lucedoriente/Aleste520ex/pcb_top.png

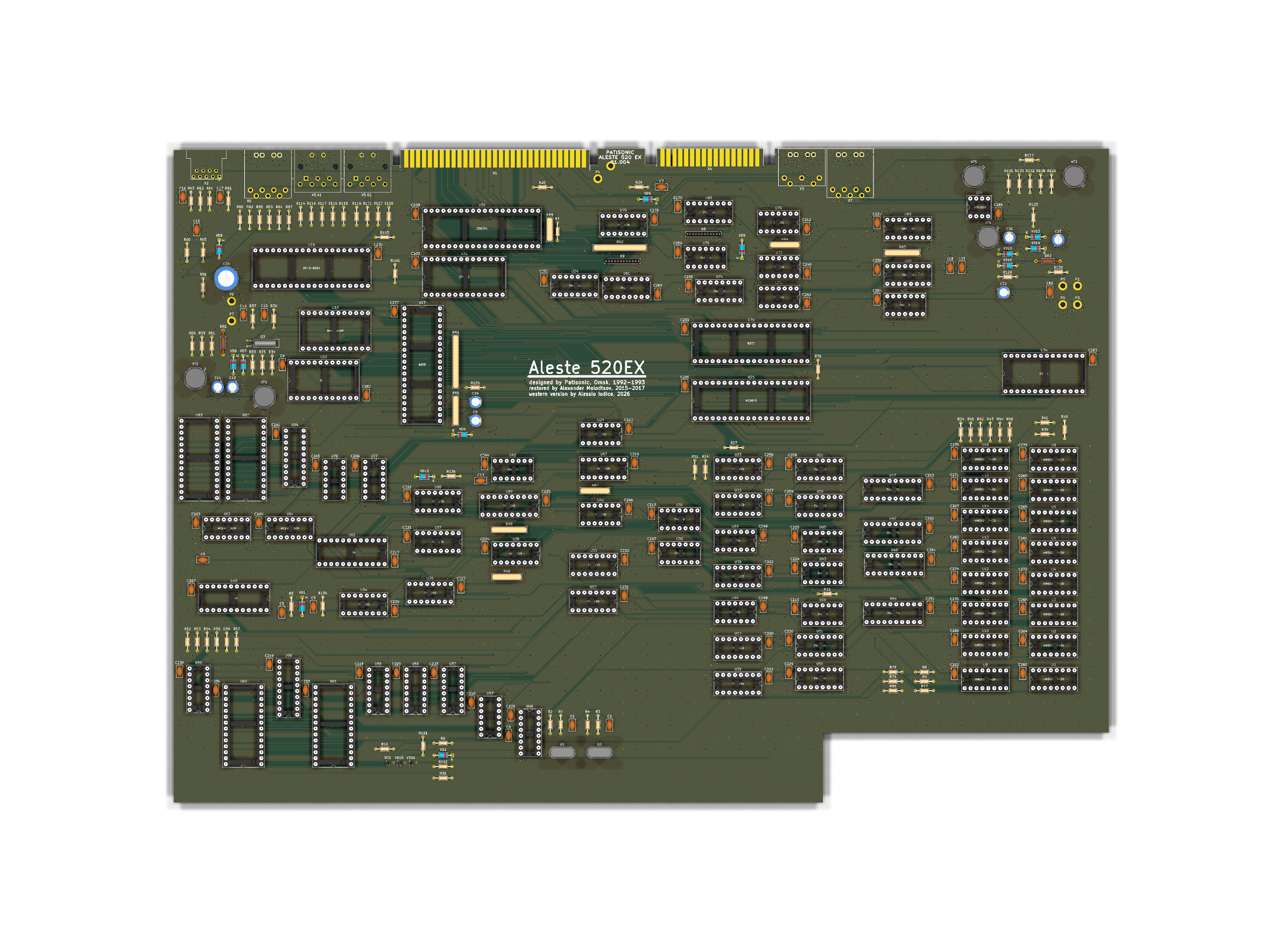
pcb_top.png
