lucedoriente/Aleste520ex/Schema/Aleste-Schematic1.gif

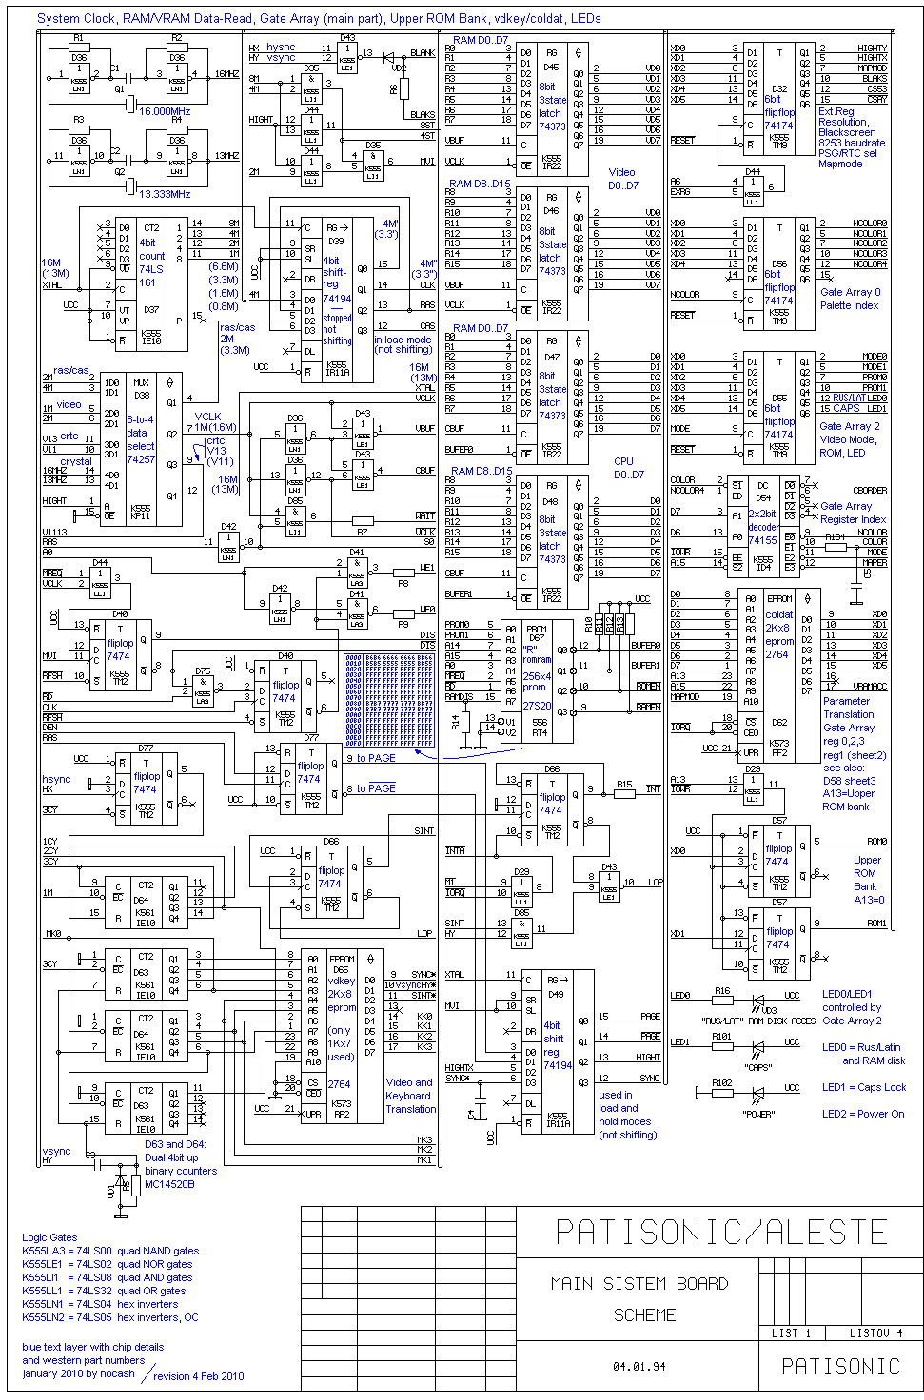
Schema/Aleste-Schematic1.gif
