lucedoriente/Aleste520ex/Schema/Aleste-Schematic2.gif

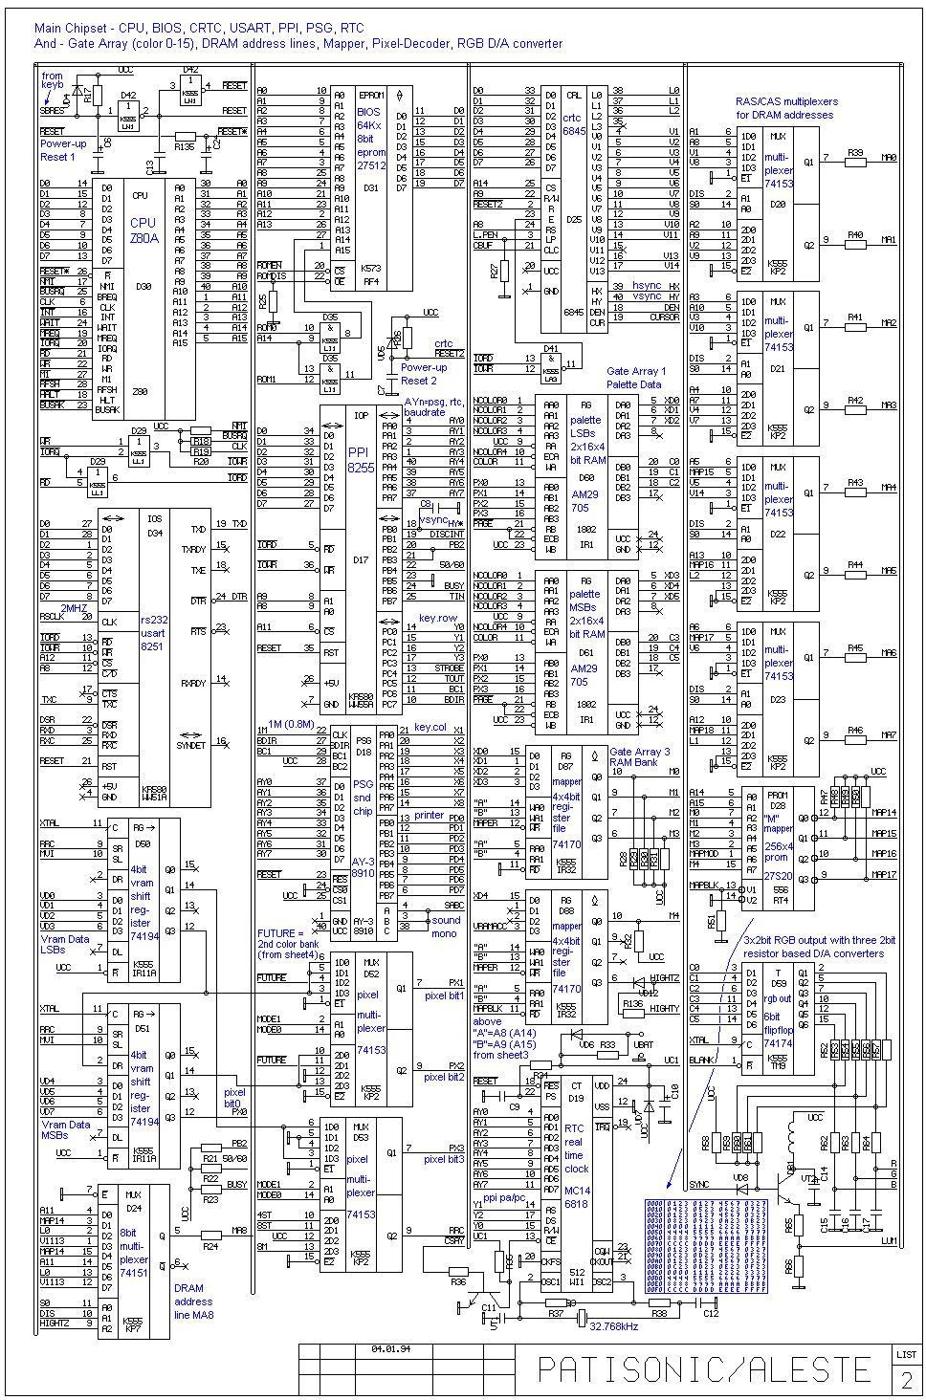
Schema/Aleste-Schematic2.gif
