lucedoriente/Aleste520ex/Schema/Aleste-Schematic3.gif

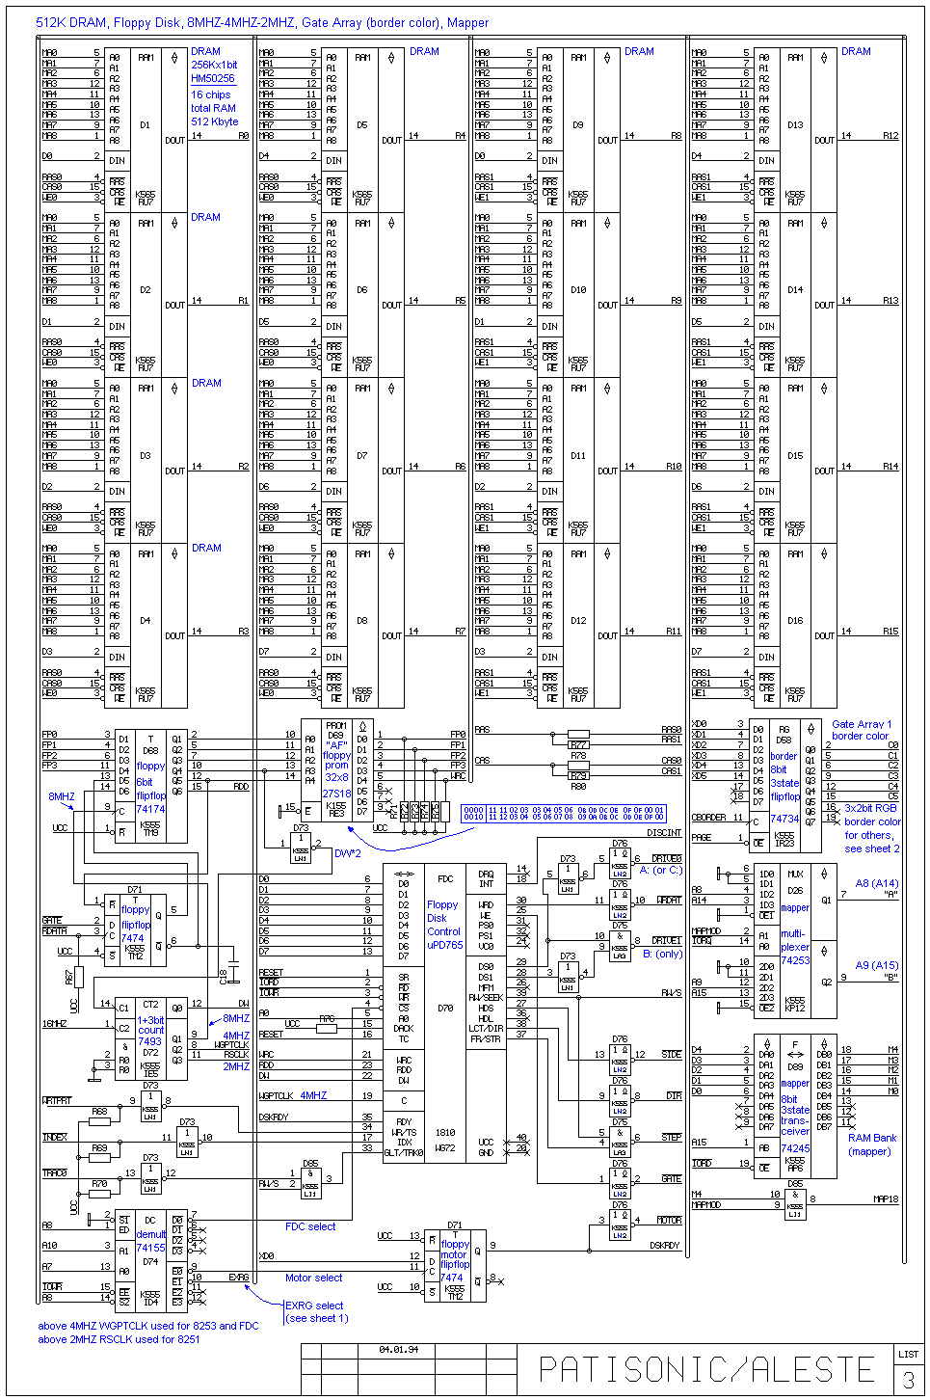
Schema/Aleste-Schematic3.gif
