lucedoriente/Aleste520ex/Schema/Aleste-Schematic4.gif

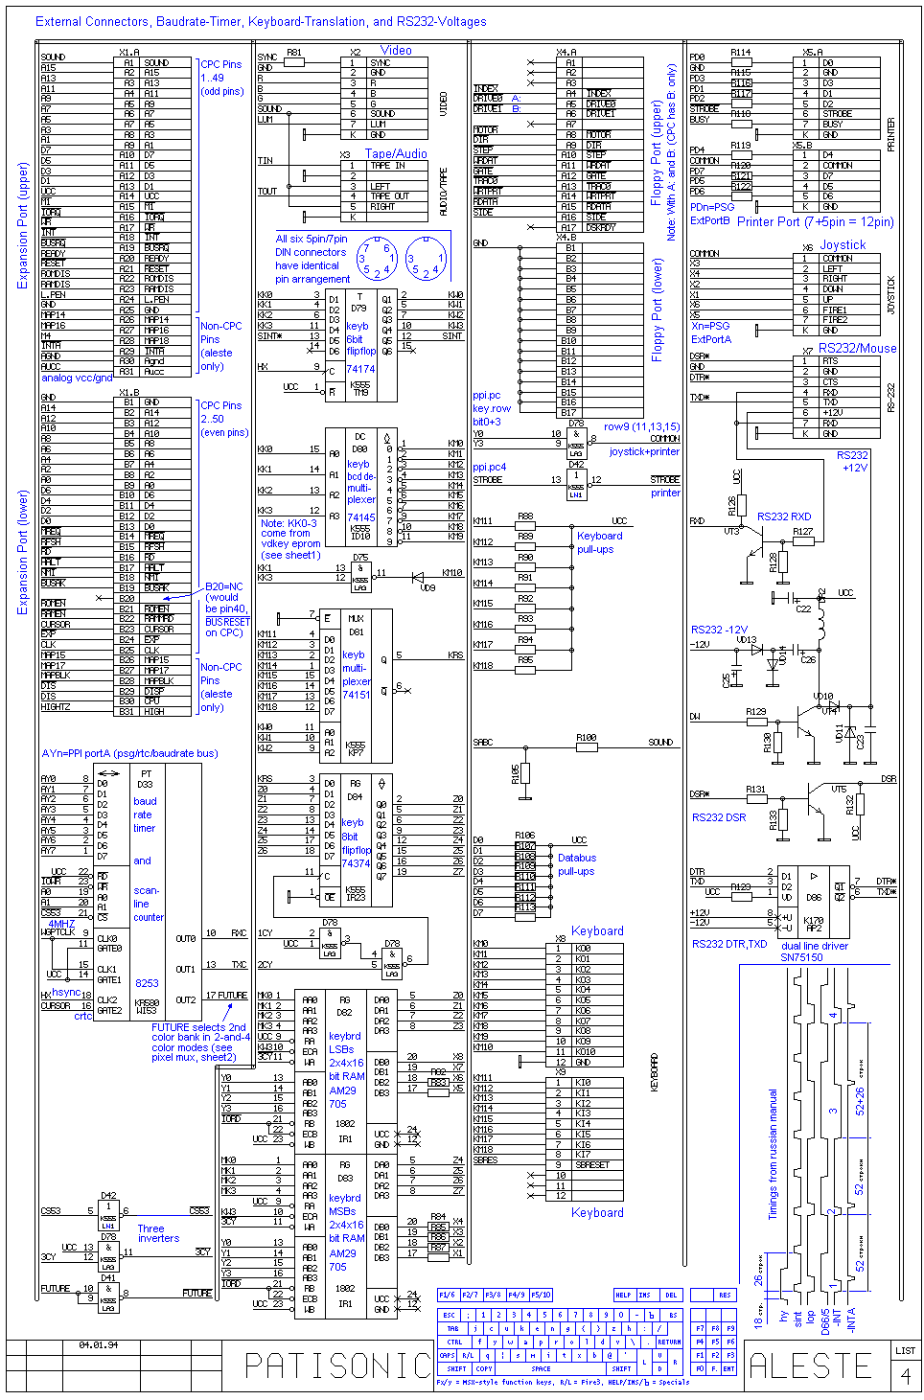
Schema/Aleste-Schematic4.gif
