lucedoriente/Aleste520ex/Componenti_Aleste520v4.csv

Tipo Componente | Numero (Designatore) | Codice / Valore Componente | Footprint THT
Circuito Integrato (IC) | U1 | HM50256P-20 | DIP-16_W7.62mm_Socket
Circuito Integrato (IC) | U2 | HM50256P-20 | DIP-16_W7.62mm_Socket
Circuito Integrato (IC) | U3 | HM50256P-20 | DIP-16_W7.62mm_Socket
Circuito Integrato (IC) | U4 | HM50256P-20 | DIP-16_W7.62mm_Socket
Circuito Integrato (IC) | U5 | HM50256P-20 | DIP-16_W7.62mm_Socket
Circuito Integrato (IC) | U6 | HM50256P-20 | DIP-16_W7.62mm_Socket
Circuito Integrato (IC) | U7 | HM50256P-20 | DIP-16_W7.62mm_Socket
Circuito Integrato (IC) | U8 | HM50256P-20 | DIP-16_W7.62mm_Socket
Circuito Integrato (IC) | U9 | HM50256P-20 | DIP-16_W7.62mm_Socket
Circuito Integrato (IC) | U10 | HM50256P-20 | DIP-16_W7.62mm_Socket
Circuito Integrato (IC) | U11 | HM50256P-20 | DIP-16_W7.62mm_Socket
Circuito Integrato (IC) | U12 | HM50256P-20 | DIP-16_W7.62mm_Socket
Circuito Integrato (IC) | U13 | HM50256P-20 | DIP-16_W7.62mm_Socket
Circuito Integrato (IC) | U14 | HM50256P-20 | DIP-16_W7.62mm_Socket
Circuito Integrato (IC) | U15 | HM50256P-20 | DIP-16_W7.62mm_Socket
Circuito Integrato (IC) | U16 | HM50256P-20 | DIP-16_W7.62mm_Socket
Circuito Integrato (IC) | U17 | 8255 | DIP-40_W15.24mm_Socket
Circuito Integrato (IC) | U18 | AY-3-8910 | DIP-40_W15.24mm_Socket
Circuito Integrato (IC) | U19 | MC146818P | DIP-24_W15.24mm_Socket
Circuito Integrato (IC) | U20 | 74LS153 | DIP-16_W7.62mm_Socket
Circuito Integrato (IC) | U21 | 74LS153 | DIP-16_W7.62mm_Socket
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
Rete Resistiva (SIP) | RN1 | 10K | R_Array_SIP9
Rete Resistiva (SIP) | RN2 | 10K | R_Array_SIP9
Rete Resistiva (SIP) | RN3 | 1,2K | R_Array_SIP6
Rete Resistiva (SIP) | RN4 | 2,7K | R_Array_SIP5
Rete Resistiva (SIP) | RN5 | 10K | R_Array_SIP5
Rete Resistiva (SIP) | RN6 | 1,2K | R_Array_SIP5
Rete Resistiva (SIP) | RN7 | 1,2K | R_Array_SIP5
Rete Resistiva (SIP) | RN8 | 1,2K | R_Array_SIP6
Rete Resistiva (SIP) | RN9 | 10K | R_Array_SIP4
Diodo | VD1 | DIODE_MY | D_DO-35_SOD27_P7.62mm_Horizontal
Diodo | VD2 | DIODE_MY | D_DO-35_SOD27_P7.62mm_Horizontal
Diodo LED | VD3 | LED_MY | LED_D3.0mm
Diodo | VD4 | DIODE_MY | D_DO-35_SOD27_P7.62mm_Horizontal
Diodo | VD5 | DIODE_MY | D_DO-35_SOD27_P7.62mm_Horizontal
Diodo | VD6 | DIODE_MY | D_DO-35_SOD27_P7.62mm_Horizontal
Diodo | VD7 | DIODE_MY | D_DO-35_SOD27_P7.62mm_Horizontal
Diodo | VD8 | DIODE_MY | D_DO-35_SOD27_P7.62mm_Horizontal
Diodo | VD9 | DIODE_MY | D_DO-35_SOD27_P7.62mm_Horizontal
Diodo | VD10 | DIODE_MY | D_DO-35_SOD27_P7.62mm_Horizontal
Diodo | VD11 | ZDIODE_MY | D_DO-35_SOD27_P7.62mm_Horizontal
Diodo | VD12 | DIODE_MY | D_DO-35_SOD27_P7.62mm_Horizontal
Diodo | VD13 | DIODE_MY | D_DO-35_SOD27_P7.62mm_Horizontal
Diodo | VD14 | DIODE_MY | D_DO-35_SOD27_P7.62mm_Horizontal
Diodo LED | VD15 | LED_MY | LED_D3.0mm
Diodo LED | VD16 | LED_MY | LED_D3.0mm
Transistor | VT1 | NPN | TO-39-3
Transistor | VT2 | NPN | TO-39-3
Transistor | VT3 | NPN | TO-39-3
Transistor | VT4 | NPN | TO-39-3
Transistor | VT5 | NPN | TO-39-3
Quarzo / Oscillatore | Q1 | 16 MHz | Crystal_HC49-U_Vertical
Quarzo / Oscillatore | Q2 | 13.333 MHz | Crystal_HC49-U_Vertical
Quarzo / Oscillatore | Q3 | QUARTZ | Crystal_AT310_D3.0mm_L10.0mm_Horizontal
Induttore / Impedenza | DR1 | 91uH | L_Axial_L5.3mm_D2.2mm_P10.16mm_Horizontal_Vishay_IM-1
Induttore / Impedenza | DR2 | 51uH | L_Axial_L5.3mm_D2.2mm_P10.16mm_Horizontal_Vishay_IM-1
Connettore | X1 | Expansion port | SLOT_62
Connettore | X2 | DB9_Male | DSUB-9_Pins_Horizontal_P2.77x2.54mm_EdgePinOffset9.40mm
Connettore | X3 | CONN-5S | DNR-5F1R
Connettore | X4 | Floppy | SLOT-34
Connettore | X5.A1 | CONN-7S | CUI_SDS-70J
Connettore | X5.B1 | CONN-7S | CUI_SDS-70J
Connettore | X6 | CONN-7S | DNR-8F1R
Connettore | X7 | CONN-7S | DNR-8F1R
Connettore | X8 | CONN-12 | PinHeader_1x12_P1.27mm_Vertical
Connettore | X9 | CONN-12 | PinHeader_1x12_P1.27mm_Vertical
Foro di Fissaggio / Piazzola | P1 | PIN | MountingHole_2.2mm_M2_DIN965_Pad
Foro di Fissaggio / Piazzola | P2 | PIN | MountingHole_2.2mm_M2_DIN965_Pad
Foro di Fissaggio / Piazzola | P3 | PIN | MountingHole_2.2mm_M2_DIN965_Pad
Foro di Fissaggio / Piazzola | P4 | PIN | MountingHole_2.2mm_M2_DIN965_Pad
Foro di Fissaggio / Piazzola | P5 | PIN | MountingHole_2.2mm_M2_DIN965_Pad
Foro di Fissaggio / Piazzola | P6 | PIN | MountingHole_2.2mm_M2_DIN965_Pad
Foro di Fissaggio / Piazzola | P7 | PIN | MountingHole_2.2mm_M2_DIN965_Pad
Foro di Fissaggio / Piazzola | P8 | PIN | MountingHole_2.2mm_M2_DIN965_Pad
