lucedoriente/Aleste520ex/Schema/Aleste-Component-Map.gif

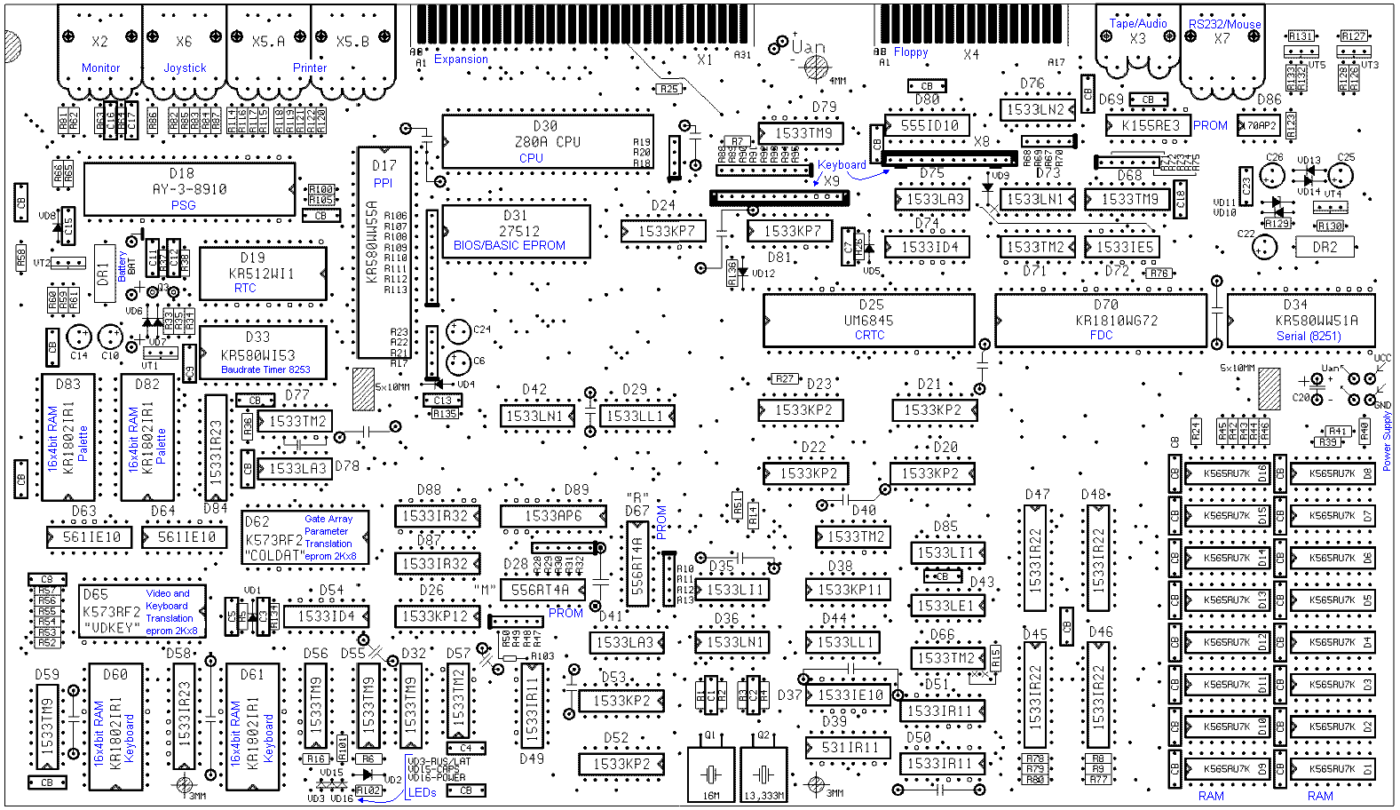
Schema/Aleste-Component-Map.gif
