lucedoriente/Aleste520ex/case/jlcpcb_3dprint/3_Aleste520_Switch_Plate_1_5mm_Whole.step

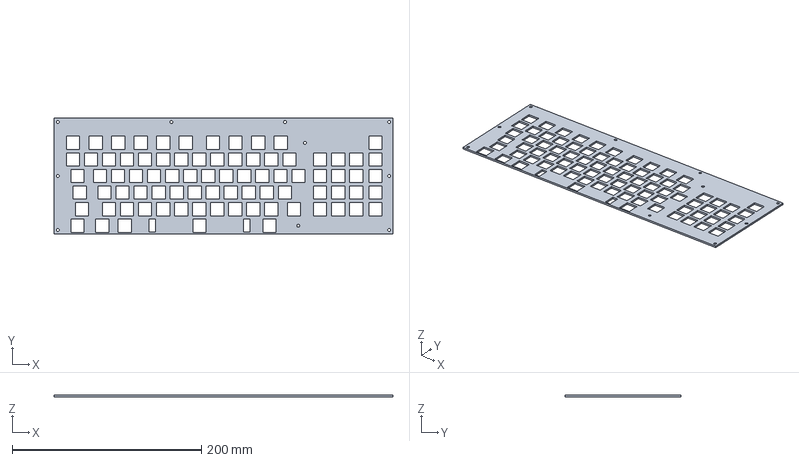
[picture p10: CAD file, 2026-10-17]
case/jlcpcb_3dprint/3_Aleste520_Switch_Plate_1_5mm_Whole.step
358.0 x 122.0 x 2.00 mm
