lucedoriente/Aleste520ex/case/jlcpcb_3dprint/1_Aleste520_Bottom_Case_Whole.step

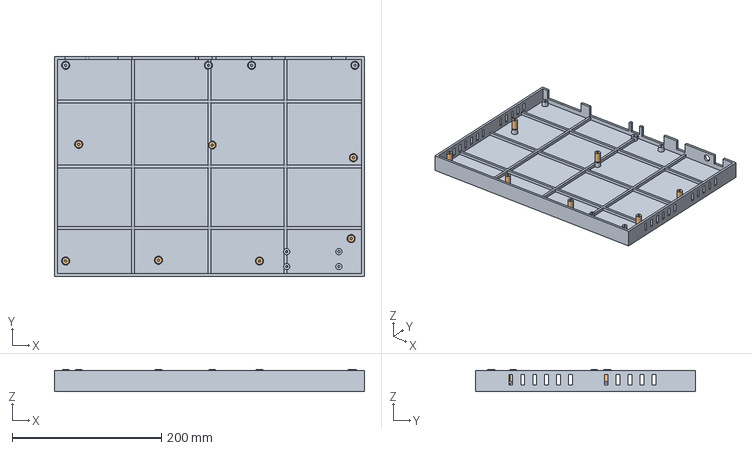
[picture p11: CAD file, 2026-10-17]
case/jlcpcb_3dprint/1_Aleste520_Bottom_Case_Whole.step
415.9 x 295.5 x 30.1 mm
