lucedoriente/Aleste520ex/case/jlcpcb_3dprint/2_Aleste520_Top_Cover_Whole.step

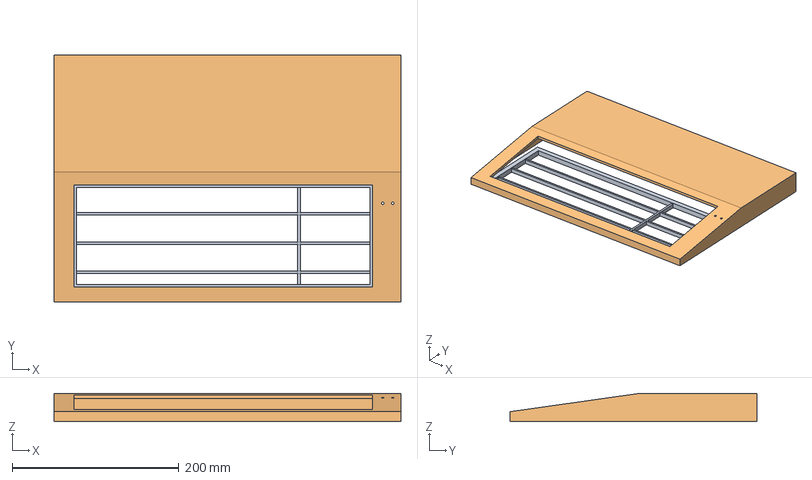
[picture p12: CAD file, 2026-10-17]
case/jlcpcb_3dprint/2_Aleste520_Top_Cover_Whole.step
415.9 x 295.5 x 34.0 mm
