lucedoriente/Aleste520ex/case/jlcpcb_3dprint/quadrants_256x256/Bottom_Q1_FrontLeft.stl

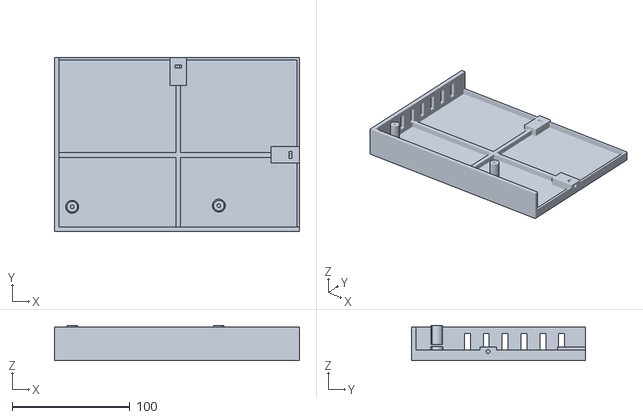
[picture p13: CAD file, 2026-10-17]
case/jlcpcb_3dprint/quadrants_256x256/Bottom_Q1_FrontLeft.stl
207.9 x 147.8 x 30.1
