lucedoriente/Aleste520ex/keyboard/3dmodels/SW_Cherry_MX_1.00u_PCB.step

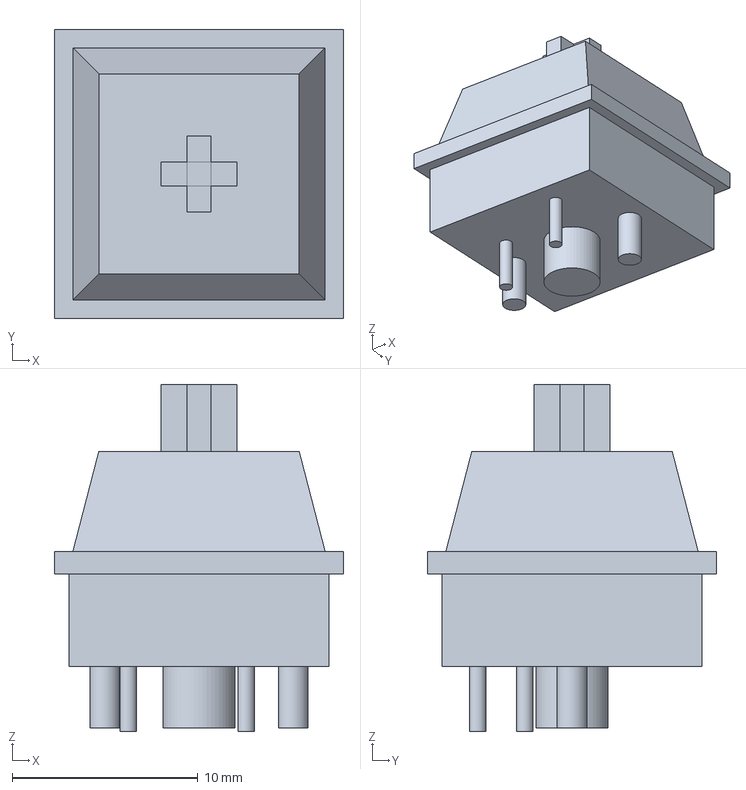
[picture p14: CAD file, 2026-10-17]
keyboard/3dmodels/SW_Cherry_MX_1.00u_PCB.step
15.6 x 15.6 x 18.7 mm
