lucedoriente/Aleste520ex/case/jlcpcb_3dprint/quadrants_256x256/Top_Q1_FrontLeft.stl

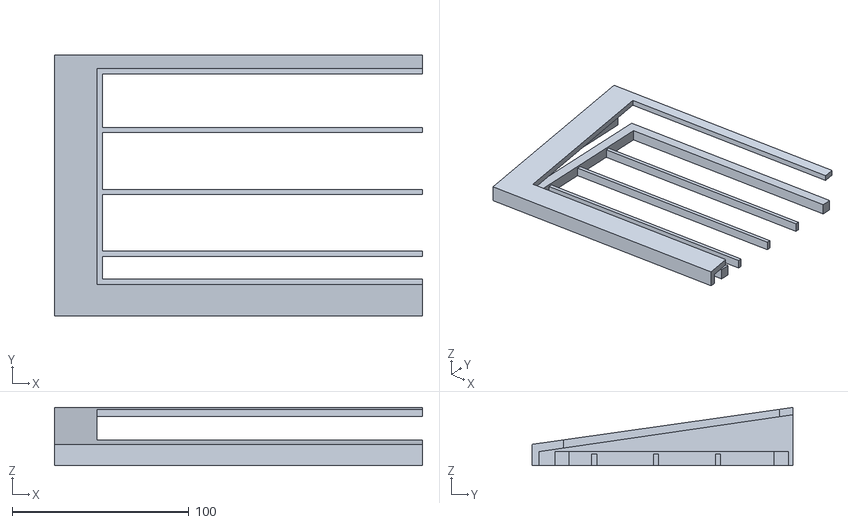
[picture p15: CAD file, 2026-10-17]
case/jlcpcb_3dprint/quadrants_256x256/Top_Q1_FrontLeft.stl
207.9 x 147.8 x 32.9
