lucedoriente/Aleste520ex/case/Aleste520_Case.step

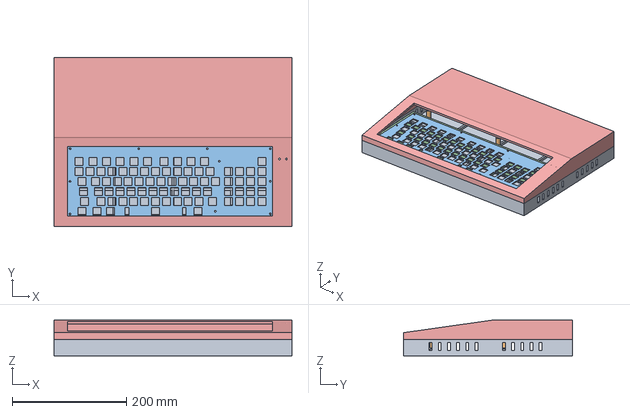
[picture p16: CAD file, 2026-10-17]
case/Aleste520_Case.step
415.9 x 295.5 x 62.5 mm
