lucedoriente/Aleste520ex/case/jlcpcb_3dprint/quadrants_256x256/Top_Q2_FrontRight.stl

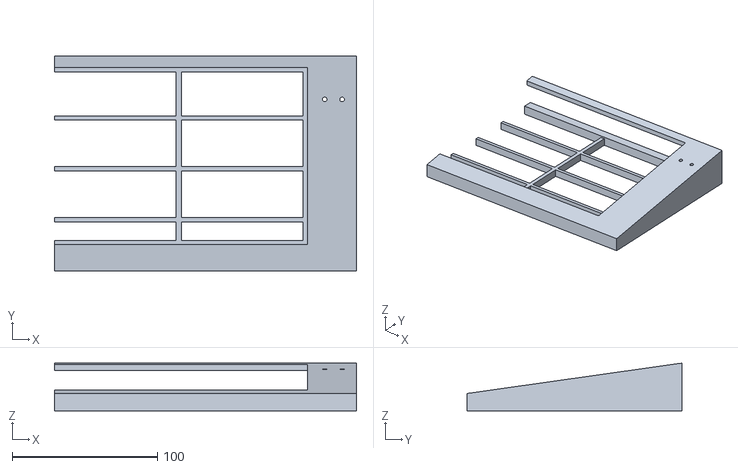
[picture p18: CAD file, 2026-10-17]
case/jlcpcb_3dprint/quadrants_256x256/Top_Q2_FrontRight.stl
207.9 x 147.8 x 32.9
