lucedoriente/Aleste520ex/case/jlcpcb_3dprint/quadrants_256x256/Bottom_Q4_RearRight.stl

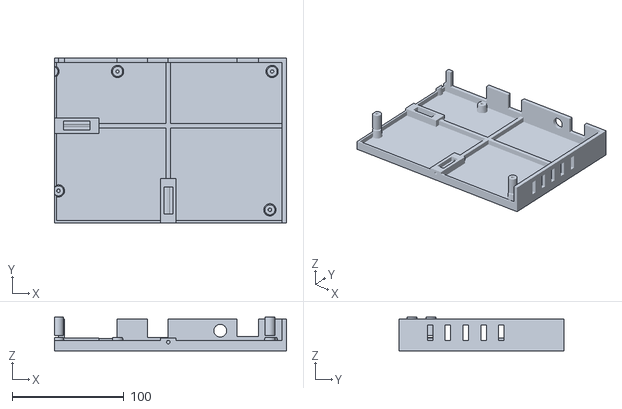
[picture p19: CAD file, 2026-10-17]
case/jlcpcb_3dprint/quadrants_256x256/Bottom_Q4_RearRight.stl
208.0 x 147.8 x 30.1
