lucedoriente/Aleste520ex/case/keyboard_plate.dxf

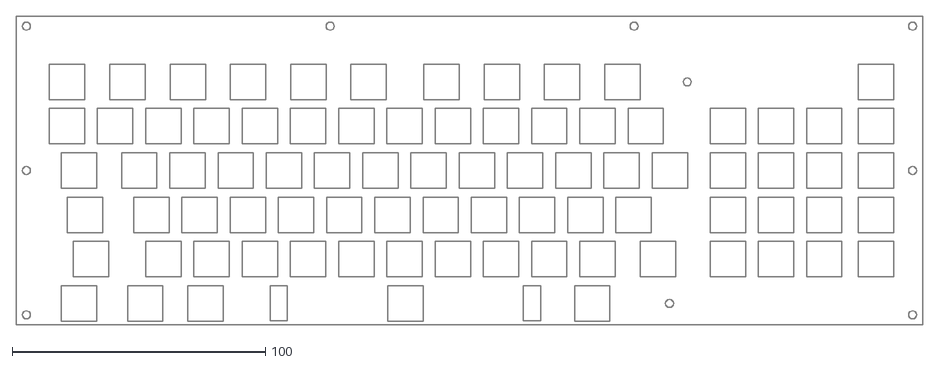
[picture p20: CAD file, 2026-10-17]
case/keyboard_plate.dxf
358.0 x 122.0
