lucedoriente/Aleste520ex/case/jlcpcb_3dprint/quadrants_256x256/Bottom_Q3_RearLeft.stl

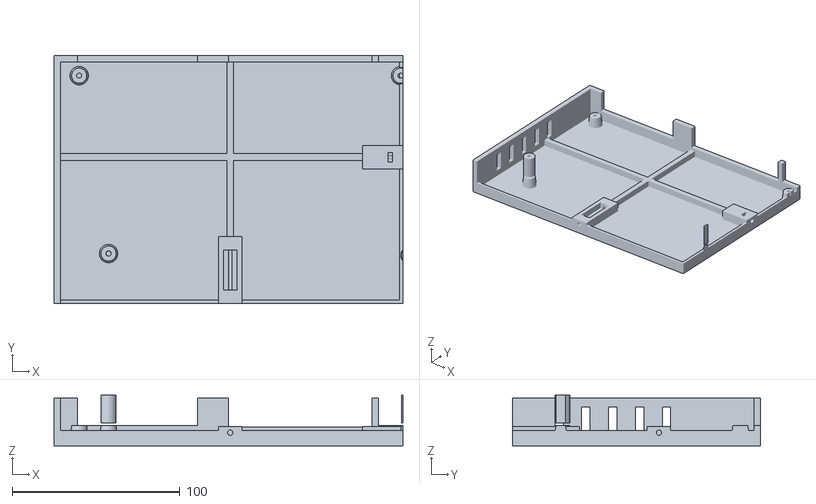
[picture p21: CAD file, 2026-10-17]
case/jlcpcb_3dprint/quadrants_256x256/Bottom_Q3_RearLeft.stl
207.9 x 147.8 x 30.1
