lucedoriente/Aleste520ex/case/jlcpcb_3dprint/quadrants_256x256/Plate_Left_Half.stl

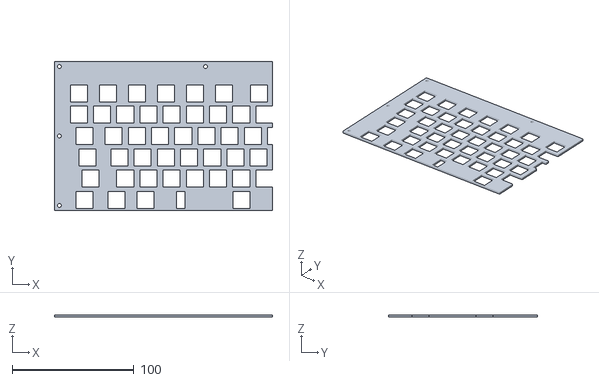
[picture p24: CAD file, 2026-10-17]
case/jlcpcb_3dprint/quadrants_256x256/Plate_Left_Half.stl
179.0 x 122.0 x 2.00
