lucedoriente/Aleste520ex/(list of files, cad)

Other CAD files:
case/Aleste520_Switch_Plate.FCStd
case/Aleste520_Bottom_Case.FCStd
case/Aleste520_Top_Cover.FCStd
case/jlcpcb_3dprint/quadrants_256x256/Top_Q3_RearLeft.stl
case/Aleste520_Case.FCStd
case/jlcpcb_3dprint/1_Aleste520_Bottom_Case_Whole.stl
case/jlcpcb_3dprint/2_Aleste520_Top_Cover_Whole.stl
case/jlcpcb_3dprint/3_Aleste520_Switch_Plate_1_5mm_Whole.stl
