lucedoriente/Aleste520ex/keyboard/Aleste520_Keyboard.kicad_pcb

## KiCad design keyboard/Aleste520_Keyboard.kicad_pcb (2026-10-17)

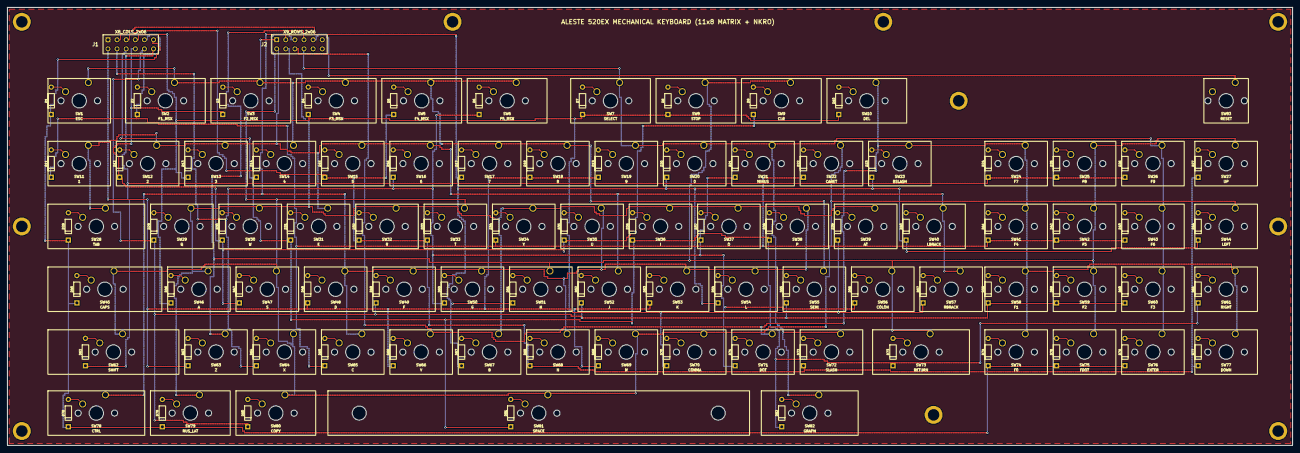
[picture p25: board Aleste520_Keyboard.kicad_pcb from above]

Board: 2 copper layers, 358.0 x 122.0 mm, 177 parts (0 on the bottom side), 103 nets.

Parts:
D1, D2, D3, D4, D5, D6, D7, D8, D9, D10, D11, D12, D13, D14, D15, D16, D17, D18, D19, D20, D21, D22, D23, D24, D25, D26, D27, D28, D29, D30, D31, D32, D33, D34, D35, D36, D37, D38, D39, D40, D41, D42, D43, D44, D45, D46, D47, D48, D49, D50, D51, D52, D53, D54, D55, D56, D57, D58, D59, D60, D61, D62, D63, D64, D65, D66, D67, D68, D69, D70, D71, D72, D73, D74, D75, D76, D77, D78, D79, D80, D81, D82: 1N4148; D_DO-35_SOD27_P7.62mm_Horizontal
J1: X8_COLS_2x06; PinHeader_2x06_P2.54mm_Vertical
J2: X9_ROWS_2x06; PinHeader_2x06_P2.54mm_Vertical
MH1, MH2, MH3, MH4, MH5, MH6, MH7, MH8, MH9, MH10: M3_AntiFlex; MountingHole_3.2mm_M3_Pad
SW1: ESC; SW_Cherry_MX_1.00u_PCB
SW2: F1_MSX; SW_Cherry_MX_1.25u_PCB
SW3: F2_MSX; SW_Cherry_MX_1.25u_PCB
SW4: F3_MSX; SW_Cherry_MX_1.25u_PCB
SW5: F4_MSX; SW_Cherry_MX_1.25u_PCB
SW6: F5_MSX; SW_Cherry_MX_1.25u_PCB
SW7: SELECT; SW_Cherry_MX_1.25u_PCB
SW8: STOP; SW_Cherry_MX_1.25u_PCB
SW9: CLR; SW_Cherry_MX_1.25u_PCB
SW10: DEL; SW_Cherry_MX_1.25u_PCB
SW11: 1; SW_Cherry_MX_1.00u_PCB
SW12: 2; SW_Cherry_MX_1.00u_PCB
SW13: 3; SW_Cherry_MX_1.00u_PCB
SW14: 4; SW_Cherry_MX_1.00u_PCB
SW15: 5; SW_Cherry_MX_1.00u_PCB
SW16: 6; SW_Cherry_MX_1.00u_PCB
SW17: 7; SW_Cherry_MX_1.00u_PCB
SW18: 8; SW_Cherry_MX_1.00u_PCB
SW19: 9; SW_Cherry_MX_1.00u_PCB
SW20: 0; SW_Cherry_MX_1.00u_PCB
SW21: MINUS; SW_Cherry_MX_1.00u_PCB
SW22: CARET; SW_Cherry_MX_1.00u_PCB
SW23: BSLASH; SW_Cherry_MX_1.00u_PCB
SW24: F7; SW_Cherry_MX_1.00u_PCB
SW25: F8; SW_Cherry_MX_1.00u_PCB
SW26: F9; SW_Cherry_MX_1.00u_PCB
SW27: UP; SW_Cherry_MX_1.00u_PCB
SW28: TAB; SW_Cherry_MX_1.50u_PCB
SW29: Q; SW_Cherry_MX_1.00u_PCB
SW30: W; SW_Cherry_MX_1.00u_PCB
SW31: E; SW_Cherry_MX_1.00u_PCB
SW32: R; SW_Cherry_MX_1.00u_PCB
SW33: T; SW_Cherry_MX_1.00u_PCB
SW34: Y; SW_Cherry_MX_1.00u_PCB
SW35: U; SW_Cherry_MX_1.00u_PCB
SW36: I; SW_Cherry_MX_1.00u_PCB
SW37: O; SW_Cherry_MX_1.00u_PCB
SW38: P; SW_Cherry_MX_1.00u_PCB
SW39: AT; SW_Cherry_MX_1.00u_PCB
SW40: LBRACK; SW_Cherry_MX_1.00u_PCB
SW41: F4; SW_Cherry_MX_1.00u_PCB
SW42: F5; SW_Cherry_MX_1.00u_PCB
SW43: F6; SW_Cherry_MX_1.00u_PCB
SW44: LEFT; SW_Cherry_MX_1.00u_PCB
SW45: CAPS; SW_Cherry_MX_1.75u_PCB
SW46: A; SW_Cherry_MX_1.00u_PCB
SW47: S; SW_Cherry_MX_1.00u_PCB
SW48: D; SW_Cherry_MX_1.00u_PCB
SW49: F; SW_Cherry_MX_1.00u_PCB
SW50: G; SW_Cherry_MX_1.00u_PCB
SW51: H; SW_Cherry_MX_1.00u_PCB
SW52: J; SW_Cherry_MX_1.00u_PCB
SW53: K; SW_Cherry_MX_1.00u_PCB
SW54: L; SW_Cherry_MX_1.00u_PCB
SW55: SEMI; SW_Cherry_MX_1.00u_PCB
SW56: COLON; SW_Cherry_MX_1.00u_PCB
SW57: RBRACK; SW_Cherry_MX_1.00u_PCB
SW58: F1; SW_Cherry_MX_1.00u_PCB
SW59: F2; SW_Cherry_MX_1.00u_PCB
SW60: F3; SW_Cherry_MX_1.00u_PCB
SW61: RIGHT; SW_Cherry_MX_1.00u_PCB
SW62: SHIFT; SW_Cherry_MX_2.00u_PCB
SW63: Z; SW_Cherry_MX_1.00u_PCB
SW64: X; SW_Cherry_MX_1.00u_PCB
SW65: C; SW_Cherry_MX_1.00u_PCB
SW66: V; SW_Cherry_MX_1.00u_PCB
SW67: B; SW_Cherry_MX_1.00u_PCB
SW68: N; SW_Cherry_MX_1.00u_PCB
SW69: M; SW_Cherry_MX_1.00u_PCB
SW70: COMMA; SW_Cherry_MX_1.00u_PCB
SW71: DOT; SW_Cherry_MX_1.00u_PCB
SW72: SLASH; SW_Cherry_MX_1.00u_PCB
SW73: RETURN; SW_Cherry_MX_1.50u_PCB
SW74: F0; SW_Cherry_MX_1.00u_PCB
SW75: FDOT; SW_Cherry_MX_1.00u_PCB
SW76: ENTER; SW_Cherry_MX_1.00u_PCB
SW77: DOWN; SW_Cherry_MX_1.00u_PCB
SW78: CTRL; SW_Cherry_MX_1.50u_PCB
SW79: RUS_LAT; SW_Cherry_MX_1.25u_PCB
SW80: COPY; SW_Cherry_MX_1.25u_PCB
SW81: SPACE; SW_Cherry_MX_6.25u_PCB
SW82: GRAPH; SW_Cherry_MX_1.50u_PCB
SW83: RESET; SW_Cherry_MX_1.00u_PCB

Connections:
GND: J1.1, J2.12, MH1.1, MH2.1, MH3.1, MH4.1, MH5.1, MH6.1, MH7.1, MH8.1, MH9.1, MH10.1, SW83.1
KM0: D24.1, D25.1, D26.1, D62.1, J1.12
KM1: D1.1, D28.1, D45.1, D74.1, D75.1, D76.1, D78.1, D79.1, J1.11
KM2: D29.1, D49.1, D52.1, D55.1, D58.1, D59.1, D60.1, D80.1, J1.10
KM3: D2.1, D11.1, D22.1, D34.1, D41.1, D42.1, D43.1, D65.1, J1.9
KM4: D3.1, D9.1, D12.1, D30.1, D35.1, D47.1, J1.8
KM5: D4.1, D7.1, D8.1, D10.1, D13.1, D46.1, D53.1, D69.1, J1.7
KM6: D14.1, D31.1, D36.1, D38.1, D61.1, D73.1, D81.1, D82.1, J1.6
KM7: D5.1, D15.1, D27.1, D32.1, D33.1, D68.1, D72.1, D77.1, J1.5
KM8: D6.1, D16.1, D21.1, D37.1, D50.1, D56.1, D64.1, D71.1, J1.4
KM9: D17.1, D20.1, D23.1, D40.1, D44.1, D51.1, D54.1, D67.1, J1.3
KM10: D18.1, D19.1, D39.1, D48.1, D57.1, D63.1, D66.1, D70.1, J1.2
KM11: J2.1, SW1.2, SW2.2, SW3.2, SW4.2, SW5.2, SW6.2, SW14.2, SW17.2, SW18.2, SW55.2
KM12: J2.2, SW11.2, SW12.2, SW13.2, SW15.2, SW16.2, SW28.2, SW31.2, SW40.2, SW52.2, SW57.2
KM13: J2.3, SW35.2, SW38.2, SW48.2, SW49.2, SW50.2, SW53.2, SW54.2, SW65.2, SW68.2, SW78.2
KM14: J2.4, SW29.2, SW30.2, SW32.2, SW34.2, SW36.2, SW37.2, SW39.2, SW46.2, SW67.2, SW79.2
KM15: J2.5, SW22.2, SW33.2, SW44.2, SW45.2, SW47.2, SW62.2, SW64.2, SW69.2, SW70.2, SW80.2, SW81.2
KM16: J2.6, SW10.2, SW23.2, SW24.2, SW41.2, SW58.2, SW61.2, SW66.2, SW71.2, SW74.2, SW77.2
KM17: J2.7, SW8.2, SW9.2, SW25.2, SW27.2, SW42.2, SW51.2, SW56.2, SW59.2, SW63.2, SW73.2, SW75.2
KM18: J2.8, SW7.2, SW19.2, SW20.2, SW21.2, SW26.2, SW43.2, SW60.2, SW72.2, SW76.2, SW82.2
unnamed: D1.2, SW1.1
unnamed: D2.2, SW2.1
unnamed: D3.2, SW3.1
unnamed: D4.2, SW4.1
unnamed: D5.2, SW5.1
unnamed: D6.2, SW6.1
unnamed: D7.2, SW7.1
unnamed: D8.2, SW8.1
unnamed: D9.2, SW9.1
unnamed: D10.2, SW10.1
unnamed: D11.2, SW11.1
unnamed: D12.2, SW12.1
unnamed: D13.2, SW13.1
unnamed: D14.2, SW14.1
unnamed: D15.2, SW15.1
unnamed: D16.2, SW16.1
unnamed: D17.2, SW17.1
unnamed: D18.2, SW18.1
unnamed: D19.2, SW19.1
unnamed: D20.2, SW20.1
unnamed: D21.2, SW21.1
unnamed: D22.2, SW22.1
unnamed: D23.2, SW23.1
unnamed: D24.2, SW24.1
unnamed: D25.2, SW25.1
unnamed: D26.2, SW26.1
unnamed: D27.2, SW27.1
unnamed: D28.2, SW28.1
unnamed: D29.2, SW29.1
unnamed: D30.2, SW30.1
unnamed: D31.2, SW31.1
unnamed: D32.2, SW32.1
unnamed: D33.2, SW33.1
unnamed: D34.2, SW34.1
unnamed: D35.2, SW35.1
unnamed: D36.2, SW36.1
unnamed: D37.2, SW37.1
unnamed: D38.2, SW38.1
unnamed: D39.2, SW39.1
unnamed: D40.2, SW40.1
unnamed: D41.2, SW41.1
unnamed: D42.2, SW42.1
unnamed: D43.2, SW43.1
unnamed: D44.2, SW44.1
unnamed: D45.2, SW45.1
unnamed: D46.2, SW46.1
unnamed: D47.2, SW47.1
unnamed: D48.2, SW48.1
unnamed: D49.2, SW49.1
unnamed: D50.2, SW50.1
unnamed: D51.2, SW51.1
unnamed: D52.2, SW52.1
unnamed: D53.2, SW53.1
unnamed: D54.2, SW54.1
unnamed: D55.2, SW55.1
unnamed: D56.2, SW56.1
unnamed: D57.2, SW57.1
unnamed: D58.2, SW58.1
unnamed: D59.2, SW59.1
unnamed: D60.2, SW60.1
unnamed: D61.2, SW61.1
unnamed: D62.2, SW62.1
unnamed: D63.2, SW63.1
unnamed: D64.2, SW64.1
unnamed: D65.2, SW65.1
unnamed: D66.2, SW66.1
unnamed: D67.2, SW67.1
unnamed: D68.2, SW68.1
unnamed: D69.2, SW69.1
unnamed: D70.2, SW70.1
unnamed: D71.2, SW71.1
unnamed: D72.2, SW72.1
unnamed: D73.2, SW73.1
unnamed: D74.2, SW74.1
unnamed: D75.2, SW75.1
unnamed: D76.2, SW76.1
unnamed: D77.2, SW77.1
unnamed: D78.2, SW78.1
unnamed: D79.2, SW79.1
unnamed: D80.2, SW80.1
unnamed: D81.2, SW81.1
unnamed: D82.2, SW82.1
SBRES: J2.9, SW83.2
