lucedoriente/Aleste520ex/kicad/aleste.kicad_pcb

## KiCad design kicad/aleste.kicad_pcb (2022-07-27)

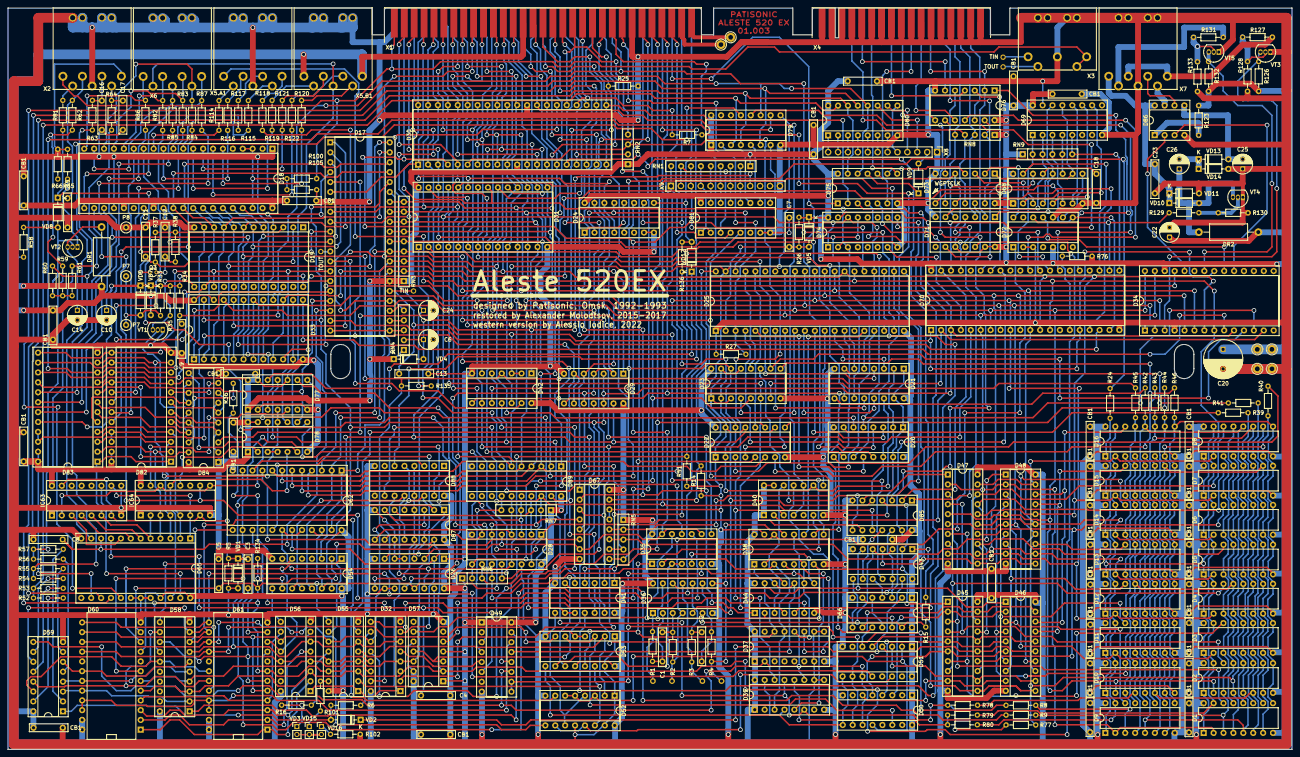
[picture p26: board aleste.kicad_pcb from above]

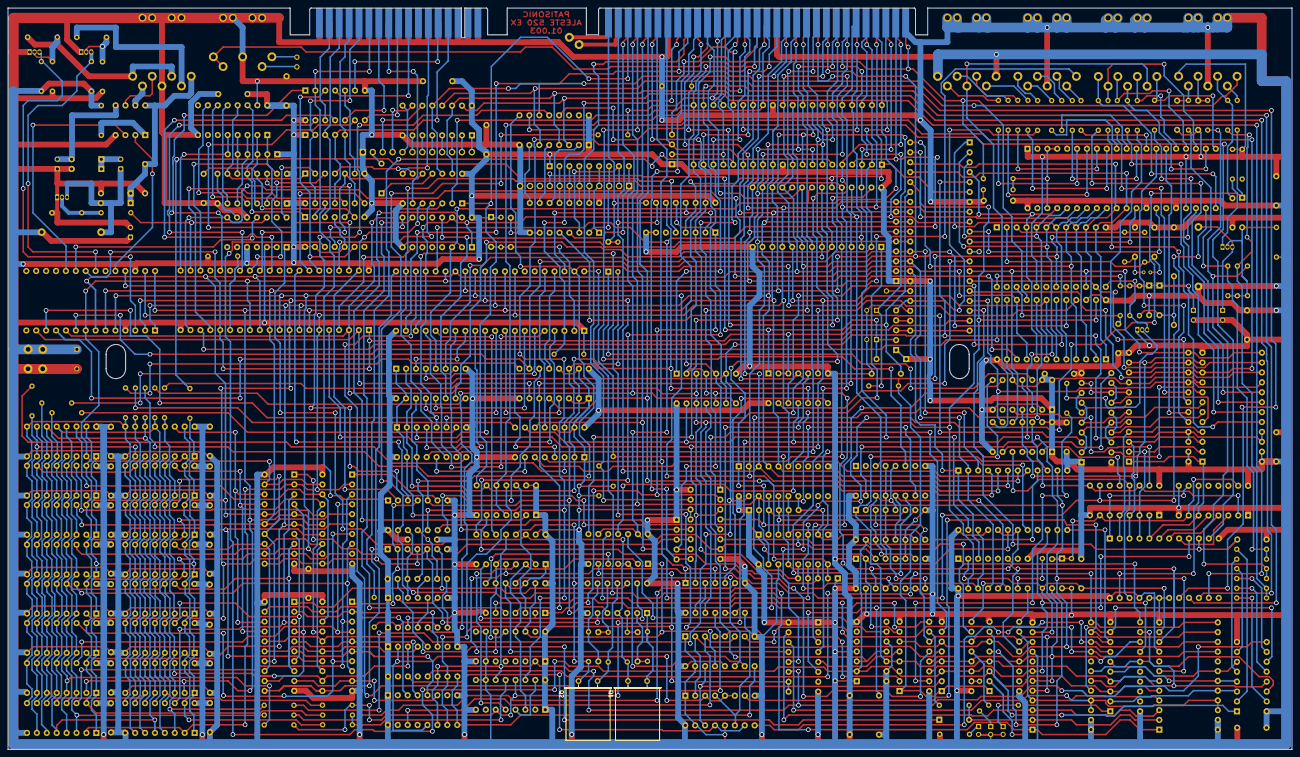
[picture p27: board aleste.kicad_pcb from below]

Board: 2 copper layers, 329.2 x 190.1 mm, 279 parts (2 on the bottom side), 452 nets.

Parts:
C1, C2: 470; C_Disc_D7.5_P2.5
C3, C4, C5, C15, C16, C17, C18: CAP; C_Disc_D7.5_P2.5
C6, C24: 1мк; C_Radial_D5_L6_P2.5
C7: 0,33мк; C_Disc_D7.5_P2.5
C8: 1н; C_Disc_D7.5_P2.5
C9: 1,5мк; C_Disc_D7.5_P2.5
C10, C14, C22: 100мк; C_Radial_D5_L6_P2.5
C11: 12; C_Disc_D7.5_P2.5
C12: 24; C_Disc_D7.5_P2.5
C13: 47н; C_Disc_D7.5_P2.5
C20: 1000мк; C_Radial_D10_L16_P5
C23: 0,47мк; C_Disc_D7.5_P2.5
C25, C26: 47мк; C_Radial_D5_L6_P2.5
CB1, CB1#2, CB1#3, CB1#4, CB1#5, CB1#6, CB1#7, CB1#8, CB1#9, CB1#10, CB1#11, CB1#12, CB1#13, CB1#14, CB1#15, CB1#16, CB1#17, CB1#18, CB1#19, CB1#20, CB1#21, CB1#22, CB1#23, CB1#24, CB1#25, CB1#26, CB1#27, CB1#28, CB1#29, CB1#30: 0,1мк; C_Disc_D7.5_P2.5
D1, D2, D3, D4, D5, D6, D7, D8, D9, D10, D11, D12, D13, D14, D15, D16: HM50256P-20; DIP-16_W7.62mm
D17: 8255; DIP-40_W15.24mm_Socket
D18: AY-3-8910; DIP-40_W15.24mm_Socket
D19: MC146818; DIP-24_W15.24mm_Socket
D20, D21, D22, D23, D52, D53: 74LS153; DIP-16_W7.62mm_Socket
D24, D81: 74LS151; DIP-16_W7.62mm_Socket
D25: MC6845P; DIP-40_W15.24mm_Socket
D26: 74LS253; DIP-16_W7.62mm_Socket
D28, D67: AM27S20; DIP-16_W7.62mm_Socket
D29, D44: 74LS32; DIP-14_W7.62mm_Socket
D30: Z80; DIP-40_W15.24mm_Socket
D31: 27512; DIP-28_W15.24mm_Socket
D32, D55, D56, D59, D68, D79: 74LS174; DIP-16_W7.62mm_Socket
D33: 8253; DIP-24_W15.24mm_Socket
D34: 8251A; DIP-28_W15.24mm_Socket
D35, D85: 74LS08; DIP-14_W7.62mm_Socket
D36, D42, D73: 74LS04; DIP-14_W7.62mm_Socket
D37: 74LS161; DIP-16_W7.62mm_Socket
D38: 74LS257; DIP-16_W7.62mm_Socket
D39, D49, D50, D51: 74LS194; DIP-16_W7.62mm_Socket
D40, D57, D66, D71, D77: 74LS74; DIP-14_W7.62mm_Socket
D41, D75, D78: 74LS00; DIP-14_W7.62mm_Socket
D43: 74LS33; DIP-14_W7.62mm_Socket
D45, D46, D47, D48: 74LS373; DIP-20_W7.62mm_Socket
D54, D74: 74LS155; DIP-16_W7.62mm_Socket
D58, D84: 74LS374; DIP-20_W7.62mm_Socket
D60, D61: 1802ИР1; DIP-24
D62, D65: 2716; DIP-24_W15.24mm_Socket
D69: 27S18; DIP-16_W7.62mm_Socket
D70: UPD765AC; DIP-40_W15.24mm_Socket
D72: 74LS93; DIP-14_W7.62mm_Socket
D76: 74LS05; DIP-14_W7.62mm_Socket
D80: 74LS145; DIP-16_W7.62mm_Socket
D82, D83: 1802ИР1; DIP-24_W15.24mm_Socket
D86: SN75150; DIP-8_W7.62mm_Socket
D87, D88: 74LS170; DIP-16_W7.62mm_Socket
D89: 74LS245; DIP-20_W7.62mm_Socket
DR1: 91мкГ; L_Axial_L9.5mm_D4.0mm_P15.24mm_Horizontal_Fastron_SMCC
DR2: 51мкГ; L_Axial_L9.5mm_D4.0mm_P15.24mm_Horizontal_Fastron_SMCC
IC63, IC64: MC14520BDP; DIP-16_W7.62mm_Socket
P1, P2, P3, P4, P5, P6, P7, P7#2, P8: PIN
Q1: 16 MHz; Crystal_HC49-U_Horizontal
Q2: 13.333 MHz; Crystal_HC49-U_Horizontal
Q3: QUARTZ; Crystal_DS15_D1.5mm_L5.0mm_Vertical
R1, R2, R3, R4, R36, R51, R60, R100, R105: 1,2к; R_Axial_DIN0204_L3.6mm_D1.6mm_P7.62mm_Horizontal
R5, R6, R14, R15, R25, R76, R82, R83, R84, R85, R86, R87, R123, R126, R132: 2,7к; R_Axial_DIN0204_L3.6mm_D1.6mm_P7.62mm_Horizontal
R7, R8, R9, R24, R39, R40, R41, R42, R43, R44, R45, R46, R77, R78, R79, R80: 51; R_Axial_DIN0204_L3.6mm_D1.6mm_P7.62mm_Horizontal
R16, R53, R55, R57, R101, R102, R134: 360; R_Axial_DIN0204_L3.6mm_D1.6mm_P7.62mm_Horizontal
R26, R34: 10k; R_Axial_DIN0204_L3.6mm_D1.6mm_P7.62mm_Horizontal
R27, R33, R135: 10к; R_Axial_DIN0204_L3.6mm_D1.6mm_P7.62mm_Horizontal
R35: 390к; R_Axial_DIN0204_L3.6mm_D1.6mm_P7.62mm_Horizontal
R37: 10М; R_Axial_DIN0204_L3.6mm_D1.6mm_P7.62mm_Horizontal
R38: 470к; R_Axial_DIN0204_L3.6mm_D1.6mm_P7.62mm_Horizontal
R52, R54, R56: 200; R_Axial_DIN0204_L3.6mm_D1.6mm_P7.62mm_Horizontal
R58, R129: 510; R_Axial_DIN0204_L3.6mm_D1.6mm_P7.62mm_Horizontal
R59, R127, R131: 6,8к; R_Axial_DIN0204_L3.6mm_D1.6mm_P7.62mm_Horizontal
R61, R128, R133: 3,3к; R_Axial_DIN0204_L3.6mm_D1.6mm_P7.62mm_Horizontal
R62, R63, R64, R66, R81, R130: 220; R_Axial_DIN0204_L3.6mm_D1.6mm_P7.62mm_Horizontal
R65: 120; R_Axial_DIN0204_L3.6mm_D1.6mm_P7.62mm_Horizontal
R114, R115, R116, R117, R118, R119, R120, R121, R122: 27; R_Axial_DIN0204_L3.6mm_D1.6mm_P7.62mm_Horizontal
R136: RES; R_Axial_DIN0204_L3.6mm_D1.6mm_P7.62mm_Horizontal
RN1, RN3: 10k; R_Array_SIP9
RN2: 10k; R_Array_SIP4
RN4: 10k; R_Array_SIP5
RN5, RN6: 1.2k; R_Array_SIP5
RN7, RN9: 1.2k; R_Array_SIP6
RN8: 2,7k; R_Array_SIP5
VD1, VD2, VD4, VD5, VD6, VD7, VD8, VD9, VD10, VD12, VD13, VD14: Diode; D_DO-35_SOD27_P7.62mm_Horizontal
VD3: DA; PinHeader_1x02_P2.00mm_Vertical
VD11: ZDiode; D_DO-35_SOD27_P7.62mm_Horizontal
VD15: CAPS; PinHeader_1x02_P2.00mm_Vertical
VD16: PWR; PinHeader_1x02_P2.00mm_Vertical
VT1, VT2, VT3, VT4, VT5: NPN; TO-92_Inline
X1: SLOT-62; SLOT_62
X2, X5.A1, X5.B1, X6, X7: CONN-7S; DNR-8F1R
X3: CONN-5S; DNR-5F1R
X4: SLOT-34
X8, X9: CONN-12; PinHeader_1x12_P2.54mm_Vertical

Connections:
/1CY: D78.2, IC64.12 (Q1B)
/1M: D18.22 (CLOCK), D37.11 (Q3), D38.5 (I0b), IC64.10 (EB)
/2CY: D65.22 (A9), D78.5, IC64.13 (Q2B)
/2M: D37.12 (Q2), D38.2 (I0a), D38.6 (I1b), D44.9
/3CY: D78.12, IC63.2 (EA), IC64.9 (CB), IC64.14 (Q3B)
/4M: D35.2, D37.13 (Q1), D38.3 (I1a), D39.3 (P0)
/8M: D35.1, D37.14 (Q0), D44.13, D53.13 (I3b)
/16MHZ: D36.4, D38.14 (I0c), D72.1 (CP1..3), Q1.1, R2.2
/A0: D30.30 (A0), D31.10 (A0), D33.19 (A0), D41.2, D42.9, D67.3 (A4), D70.5 (A0), X1.B9
/A1: D20.6 (I0a), D30.31 (A1), D31.9 (A1), D33.20 (A1), X1.A9
/A2: D20.10 (I0b), D30.32 (A2), D31.8 (A2), X1.B8
/A3: D21.6 (I0a), D30.33 (A3), D31.7 (A3), X1.A8
/A4: D21.10 (I0b), D30.34 (A4), D31.6 (A4), X1.B7
/A5: D22.6 (I0a), D30.35 (A5), D31.5 (A5), X1.A7
/A6: D23.6 (I0a), D30.36 (A6), D31.4 (A6), D44.4, X1.B6
/A7: D21.11 (I1b), D30.37 (A7), D31.3 (A7), D74.13 (A0), X1.A6
/A8: D17.9 (A0), D20.5 (I1a), D25.24 (RS), D26.4 (I2a), D30.38 (A8), D31.25 (A8), D34.12 (C/D), D74.1 (Ea1), D74.14 (Eb1), X1.B5
/A9: D17.8 (A1), D20.11 (I1b), D25.22 (R/~W), D26.12 (I2b), D30.39 (A9), D31.24 (A9), X1.A5
/A10: D21.5 (I1a), D30.40 (A10), D31.21 (A10), D74.3 (A1), X1.B4
/A11: D17.6 (~CS), D24.4 (I0), D24.14 (I5), D30.1 (A11), D31.23 (A11), X1.A4
/A12: D23.10 (I0b), D30.2 (A12), D31.2 (A12), D34.11 (CS), X1.B3
/A13: D22.10 (I0b), D29.13, D30.3 (A13), D31.26 (A13), D62.23 (A8), X1.A3
/A14: D25.25 (~CS), D26.3 (I3a), D28.5 (A0), D30.4 (A14), D35.9, D35.13, D67.7 (A2), X1.B2
/A15: D26.13 (I3b), D28.6 (A1), D30.5 (A15), D54.14 (Eb1), D62.22 (A9), D67.4 (A3), D89.1 (A->B), X1.A2
/AGND: P4.1, X1.A30
/AVCC: P3.1, X1.A31
/BUFFER0: D47.1 (OE), D67.12 (O0), RN5.2 (R1.2)
/BUFFER1: D48.1 (OE), D67.11 (O1), RN5.3 (R2.2)
/CAS: D39.12 (Q3), R79.1, R80.1
/CBUF: D25.21 (CLK), D43.4, D47.11 (LE), D48.11 (LE)
/CLK: D30.6 (~CLK), D39.14 (Q1), D40.3 (C), RN2.3 (R2), X1.B25
/CPU/LOP: D43.10, D66.4 (~S)
/CPU/~RESET*: C24.1, D30.26 (~RESET), R135.2
/CS53: D32.12 (Q4), D42.5
/CURSOR: D25.19 (CURSOR), D33.16 (G2), X1.B23
/Clocks & CRTC/13MHZ: D36.8, D38.13 (I1c), Q2.1, R4.2
/Clocks & CRTC/V11: D25.14 (MA10), D38.10 (I1d)
/Clocks & CRTC/V13: D25.16 (MA12), D38.11 (I0d)
/Clocks & CRTC/~RESET2: C7.2, D25.2 (~RESET), R26.1, VD5.2 (A)
/D0: D1.2 (DIN), D9.2 (DIN), D17.34 (D0), D25.33 (D0), D30.14 (D0), D31.11 (D0), D34.27 (D0), D47.2 (O0), D48.2 (O0), D62.8 (A0), D70.6 (DB0), D89.6 (A4), RN3.9 (R8), X1.B13
/D1: D2.2 (DIN), D10.2 (DIN), D17.33 (D1), D25.32 (D1), D30.15 (D1), D31.12 (D1), D34.28 (D1), D47.5 (O1), D48.5 (O1), D62.7 (A1), D70.7 (DB1), D89.5 (A3), RN3.8 (R7), X1.A13
/D2: D3.2 (DIN), D11.2 (DIN), D17.32 (D2), D25.31 (D2), D30.12 (D2), D31.13 (D2), D34.1 (D2), D47.6 (O2), D48.6 (O2), D62.6 (A2), D70.8 (DB2), D89.4 (A2), RN3.7 (R6), X1.B12
/D3: D4.2 (DIN), D12.2 (DIN), D17.31 (D3), D25.30 (D3), D30.8 (D3), D31.15 (D3), D34.2 (D3), D47.9 (O3), D48.9 (O3), D62.5 (A3), D70.9 (DB3), D89.3 (A1), RN3.6 (R5), X1.A12
/D4: D5.2 (DIN), D13.2 (DIN), D17.30 (D4), D25.29 (D4), D30.7 (D4), D31.16 (D4), D34.5 (D4), D47.12 (O4), D48.12 (O4), D62.4 (A4), D70.10 (DB4), D89.2 (A0), RN3.5 (R4), X1.B11
/D5: D6.2 (DIN), D14.2 (DIN), D17.29 (D5), D25.28 (D5), D30.9 (D5), D31.17 (D5), D34.6 (D5), D47.15 (O5), D48.15 (O5), D62.3 (A5), D70.11 (DB5), RN3.4 (R3), X1.A11
/D6: D7.2 (DIN), D15.2 (DIN), D17.28 (D6), D25.27 (D6), D30.10 (D6), D31.18 (D6), D34.7 (D6), D47.16 (O6), D48.16 (O6), D54.13 (A0), D62.2 (A6), D70.12 (DB6), RN3.3 (R2), X1.B10
/D7: D8.2 (DIN), D16.2 (DIN), D17.27 (D7), D25.26 (D7), D30.13 (D7), D31.19 (D7), D34.8 (D7), D47.19 (O7), D48.19 (O7), D54.3 (A1), D62.1 (A7), D70.13 (DB7), RN3.2 (R1), X1.A10
/DEN: D25.18 (DE), D77.12 (D)
/DIS: D20.2 (S1), D21.2 (S1), D22.2 (S1), D23.2 (S1), D24.10 (S1), D40.9 (Q), X1.B30
/DISCINT: D17.19 (PB1), D70.18 (INT)
/DW: D70.22 (RDW), D72.12 (Q0), R129.1
/EXRG: D44.5, D74.10 (Q1b)
/FDC/DSKRDY: D70.35 (RDY), D71.9 (Q), D76.3
/FDC/FP0: D68.3 (D0), D69.1 (Q0), RN9.2 (R1)
/FDC/FP1: D68.4 (D1), D69.2 (Q1), RN9.3 (R2)
/FDC/FP2: D68.6 (D2), D69.3 (Q2), RN9.4 (R3)
/FDC/FP3: D68.11 (D3), D69.4 (Q3), RN9.5 (R4)
/FDC/RDD: D68.15 (Q5), D70.23 (RD)
/FDC/RW/S: D70.39 (~RW/SEEK), D75.5, D85.2
/FDC/WRC: D69.5 (Q4), D70.21 (WCK), RN9.6 (R5)
/FDC/~DIR: D76.8, X4.A9
/FDC/~DRIVE0: D76.6, X4.A5
/FDC/~DRIVE1: D75.8, X4.A6
/FDC/~GATE: D71.2 (D), D76.2, X4.A12
/FDC/~INDEX: D73.11, RN8.4 (R3.2), X4.A4
/FDC/~MOTOR: D76.4, X4.A8
/FDC/~RDATA: D71.3 (C), RN8.3 (R2.2), X4.A15
/FDC/~SIDE: D76.12, X4.A16
/FDC/~STEP: D75.6, X4.A10
/FDC/~TRAC0: D73.13, RN8.2 (R1.2), X4.A13
/FDC/~WRDAT: D76.10, X4.A11
/FDC/~WRTPRT: D73.9, RN8.5 (R4.2), X4.A14
/Gate Array/4ST: D35.3, D35.4, D53.10 (I0b)
/Gate Array/8ST: D44.11, D53.11 (I1b)
/Gate Array/"A": D26.7 (Za), D87.5 (Ra), D87.14 (Wa), D88.5 (Ra), D88.14 (Wa)
/Gate Array/"B": D26.9 (Zb), D87.4 (Rb), D87.13 (Wb), D88.4 (Rb), D88.13 (Wb)
/Gate Array/B: C15.1, R62.1, X2.4
/Gate Array/BLAKS: D32.10 (Q3), R6.2
/Gate Array/BLANK: D59.1 (~Mr), R6.1, VD2.2 (A)
/Gate Array/C0: D58.2 (O0), D59.3 (D0), D60.20 (DB0)
/Gate Array/C1: D58.5 (O1), D59.4 (D1), D60.19 (DB1)
/Gate Array/C2: D58.6 (O2), D59.6 (D2), D60.18 (DB2)
/Gate Array/C3: D58.9 (O3), D59.11 (D3), D61.20 (DB0)
/Gate Array/C4: D58.12 (O4), D59.13 (D4), D61.19 (DB1)
/Gate Array/C5: D58.15 (O5), D59.14 (D5), D61.18 (DB2)
/Gate Array/CBORDER: D54.6 (Q1a), D58.11 (Cp)
/Gate Array/COLOR: C5.2, D54.2 (Ea2), D60.11 (~WA), D61.11 (~WA), R134.1
/Gate Array/G: C16.1, R63.1, X2.5
/Gate Array/HIGHTX: D32.5 (Q1), D49.5 (P2)
/Gate Array/HIGHTY: D32.2 (Q0), R136.2
/Gate Array/LED0: D55.12 (Q4), R16.1
/Gate Array/LED1: D55.15 (Q5), R101.1
/Gate Array/M0: D28.7 (A2), D87.10 (Q1), D89.14 (B4), RN7.6 (R5.2)
/Gate Array/M1: D28.4 (A3), D87.9 (Q2), D89.15 (B3), RN7.5 (R4.2)
/Gate Array/M2: D28.3 (A4), D87.7 (Q3), D89.16 (B2), RN7.4 (R3.2)
/Gate Array/M3: D28.2 (A5), D87.6 (Q4), D89.17 (B1), RN7.3 (R2.2)
/Gate Array/MAPER: D54.12 (Q3b), D87.12 (~Ew), D88.12 (~Ew)
/Gate Array/MAPMOD: D26.2 (A1), D28.1 (A6), D32.7 (Q2), D62.19 (A10), D85.9
/Gate Array/MODE: D54.11 (Q2b), D55.9 (Cp)
/Gate Array/MODE0: D52.14 (S0), D53.14 (S0), D55.2 (Q0)
/Gate Array/MODE1: D52.2 (S1), D53.2 (S1), D55.5 (Q1)
/Gate Array/NCOLOR: D54.9 (Q0b), D56.9 (Cp)
/Gate Array/NCOLOR0: D56.2 (Q0), D60.1 (AA0), D61.1 (AA0)
/Gate Array/NCOLOR1: D56.5 (Q1), D60.2 (AA1), D61.2 (AA1)
/Gate Array/NCOLOR2: D56.7 (Q2), D60.3 (AA2), D61.3 (AA2)
/Gate Array/NCOLOR3: D56.10 (Q3), D60.4 (AA3), D61.4 (AA3)
/Gate Array/NCOLOR4: D54.1 (Ea1), D56.12 (Q4), D60.10 (~ECA), D61.10 (~ECA)
/Gate Array/PAGE: D49.15 (Q0), D58.1 (OE)
/Gate Array/PX0: D51.12 (Q3), D60.13 (AB0), D61.13 (AB0)
/Gate Array/PX1: D52.7 (Za), D60.14 (AB1), D61.14 (AB1)
/Gate Array/PX2: D52.9 (Zb), D60.15 (AB2), D61.15 (AB2)
/Gate Array/PX3: D53.7 (Za), D60.16 (AB3), D61.16 (AB3)
/Gate Array/R: C17.1, R64.1, X2.3
/Gate Array/RRC: D50.9 (S0), D51.9 (S0), D53.9 (Zb)
/Gate Array/SYNC: D49.12 (Q3), R81.1, VD8.1 (K)
/Gate Array/VRAMACC: D62.17 (Q7), D88.3 (D4)
/Gate Array/XD1: D32.4 (D1), D55.4 (D1), D56.4 (D1), D57.12 (D), D58.4 (D1), D60.6 (DA1), D62.10 (Q1), D87.1 (D2)
/Gate Array/XD2: D32.6 (D2), D55.6 (D2), D56.6 (D2), D58.7 (D2), D60.7 (DA2), D62.11 (Q2), D87.2 (D3)
/Gate Array/XD3: D32.11 (D3), D55.11 (D3), D56.11 (D3), D58.8 (D3), D61.5 (DAO), D62.13 (Q3), D87.3 (D4)
/Gate Array/XD4: D32.13 (D4), D55.13 (D4), D56.13 (D4), D58.13 (D4), D61.6 (DA1), D62.14 (Q4), D88.15 (D1)
/Gate Array/XD5: D32.14 (D5), D55.14 (D5), D58.14 (D5), D61.7 (DA2), D62.15 (Q5)
/Gate Array/~PAGE: D49.14 (Q1), D60.21 (~RB), D60.22 (~ECB), D61.21 (~RB), D61.22 (~ECB)
/HIGHT: D38.1 (S), D44.10, D44.12, D49.13 (Q2)
/HIGHTZ: D24.9 (S2), R136.1, VD12.2 (A), X1.B31
/HX: D25.39 (HS), D33.18 (CLK2), D43.11, D77.3 (C), D79.9 (Cp)
/HY: C3.1, D25.40 (VS), D43.12, D85.12
/HY*: C8.1, D17.18 (PB0), D65.10 (Q1)
/KK0: D65.14 (Q4), D79.3 (D0), D80.15 (P0)
/KK1: D65.15 (Q5), D75.13, D79.4 (D1), D80.14 (P1)
/KK2: D65.16 (Q6), D79.6 (D2), D80.13 (P2)
/KK3: D65.17 (Q7), D75.12, D79.11 (D3), D80.12 (P3)
/L0: D24.2 (I2), D24.13 (I6), D25.38 (RA0)
/L1: D23.12 (I2b), D25.37 (RA1)
/L2: D22.12 (I2b), D25.36 (RA2)
/L.PEN: D25.3 (LPSTB), R27.2, X1.A24
/M4: D28.15 (A7), D85.10, D88.10 (Q1), D89.18 (B0), RN7.2 (R1.2), X1.A28
/MAP14: D24.3 (I1), D24.15 (I4), D28.12 (O0), RN6.5 (R4.2), X1.A26
/MAP15: D22.5 (I1a), D28.11 (O1), RN6.4 (R3.2), X1.B26
/MAP16: D22.11 (I1b), D28.10 (O2), RN6.3 (R2.2), X1.A27
/MAP17: D23.5 (I1a), D28.9 (O3), RN6.2 (R1.2), X1.B27
/MAP18: D23.11 (I1b), D85.8
/MAPBLK: D28.13 (CS1), D88.11 (~Er), R51.2, X1.B28
/MK0: D65.5 (A3), D82.1 (AA0), D83.1 (AA0), IC63.6 (Q3A), IC64.2 (EA)
/MK1: D65.4 (A4), D82.2 (AA1), D83.2 (AA1), IC64.3 (Q0A)
/MK2: D65.3 (A5), D82.3 (AA2), D83.3 (AA2), IC64.4 (Q1A)
/MK3: D65.2 (A6), D82.4 (AA3), D83.4 (AA3), IC64.5 (Q2A)
/MVI: D35.6, D40.11 (C), D49.9 (S0), D49.10 (S1), D50.10 (S1), D51.10 (S1)
/PROM0: D55.7 (Q2), D67.5 (A0)
/PROM1: D55.10 (Q3), D67.6 (A1)
/Periphery/50/60: D17.22 (PB4), RN4.4 (R3.2)
/Periphery/+12V: C23.2, D86.8 (VCC+), VD10.1 (K), VD11.1 (K), X7.6
/Periphery/-12V: C25.2, D86.5 (VCC-), VD13.2 (A)
/Periphery/AY0: D17.4 (PA0), D18.37 (DA0), D19.4 (AD0), D33.8 (D0)
/Periphery/AY1: D17.3 (PA1), D18.36 (DA1), D19.5 (AD1), D33.7 (D1)
/Periphery/AY2: D17.2 (PA2), D18.35 (DA2), D19.6 (AD2), D33.6 (D2)
/Periphery/AY3: D17.1 (PA3), D18.34 (DA3), D19.7 (AD3), D33.5 (D3)
/Periphery/AY4: D17.40 (PA4), D18.33 (DA4), D19.8 (AD4), D33.4 (D4)
/Periphery/AY5: D17.39 (PA5), D18.32 (DA5), D19.9 (AD5), D33.3 (D5)
/Periphery/AY6: D17.38 (PA6), D18.31 (DA6), D19.10 (AD6), D33.2 (D6)
/Periphery/AY7: D17.37 (PA7), D18.30 (DA7), D19.11 (AD7), D33.1 (D7)
/Periphery/BC1: D17.11 (PC6), D18.29 (BC1)
/Periphery/BDIR: D17.10 (PC7), D18.27 (BDIR)
/Periphery/BUSY: D17.24 (PB6), R118.1, RN4.5 (R4.2)
/Periphery/COMMON: D78.8, X5.B1.2, X6.1
/Periphery/DSR: D34.22 (DSR), R132.2, VT5.3 (C)
/Periphery/DSR*: R131.1, X7.1
/Periphery/DTR: D34.24 (DTR), D86.2 (1A)
/Periphery/DTR*: D86.7 (1Y), X7.3
/Periphery/FUTURE: D33.17 (OUT2), D41.9, D41.10
/Periphery/KM0: D80.1 (Q0), X8.12
/Periphery/KM1: D80.2 (Q1), X8.11
/Periphery/KM2: D80.3 (Q2), X8.10
/Periphery/KM3: D80.4 (Q3), X8.9
/Periphery/KM4: D80.5 (Q4), X8.8
/Periphery/KM5: D80.6 (Q5), X8.7
/Periphery/KM6: D80.7 (Q6), X8.6
/Periphery/KM7: D80.9 (Q7), X8.5
/Periphery/KM8: D80.10 (Q8), X8.4
/Periphery/KM9: D80.11 (Q9), X8.3
/Periphery/KM10: VD9.2 (A), X8.2
/Periphery/KM11: D81.4 (I0), RN1.9 (R8), X9.1
/Periphery/KM12: D81.3 (I1), RN1.8 (R7), X9.2
/Periphery/KM13: D81.2 (I2), RN1.7 (R6), X9.3
/Periphery/KM14: D81.1 (I3), RN1.6 (R5), X9.4
/Periphery/KM15: D81.15 (I4), RN1.5 (R4), X9.5
/Periphery/KM16: D81.14 (I5), RN1.4 (R3), X9.6
/Periphery/KM17: D81.13 (I6), RN1.3 (R2), X9.7
/Periphery/KM18: D81.12 (I7), RN1.2 (R1), X9.8
/Periphery/KRS: D81.5 (Z), D84.3 (D0)
/Periphery/KW0: D79.2 (Q0), D81.11 (S0)
/Periphery/KW1: D79.5 (Q1), D81.10 (S1)
/Periphery/KW2: D79.7 (Q2), D81.9 (S2)
/Periphery/KW3: D79.10 (Q3), D82.10 (~ECA), D83.10 (~ECA)
/Periphery/PB2: D17.20 (PB2), D17.21 (PB3), RN4.3 (R2.2)
/Periphery/PD0: D18.13 (IOB0), R114.1
/Periphery/PD1: D18.12 (IOB1), R116.1
/Periphery/PD2: D18.11 (IOB2), R117.1
/Periphery/PD3: D18.10 (IOB3), R115.1
/Periphery/PD4: D18.9 (IOB4), R119.1
/Periphery/PD5: D18.8 (IOB5), R121.1
/Periphery/PD6: D18.7 (IOB6), R122.1
/Periphery/PD7: D18.6 (IOB7), R120.1
/Periphery/RXC: D33.10 (OUT0), D34.25 (RXC)
/Periphery/RXD: D34.3 (RXD), R126.1, VT3.3 (C)
/Periphery/SABC: D18.3 (ANALOG_B), D18.4 (ANALOG_A), D18.38 (ANALOG_C), R100.1, R105.2
/Periphery/SBRES: C6.1, D42.1, RN4.2 (R1.2), VD4.2, X9.9
/Periphery/STROBE: D17.13 (PC4), D42.13
/Periphery/TIN: D17.25 (PB7), X3.1
/Periphery/TOUT: D17.12 (PC5), X3.4
/Periphery/TXC: D33.13 (OUT1), D34.9 (TXC)
/Periphery/TXD: D34.19 (TXD), D86.3 (2A)
/Periphery/TXD*: D86.6 (2Y), X7.5
/Periphery/VC1: C10.1, D19.24 (VDD), R33.1, R34.2, R35.2, VD6.1 (K), VD7.1 (K)
/Periphery/X1: D18.21 (IOA0), R87.2, X6.7
/Periphery/X2: D18.20 (IOA1), R86.2, X6.6
/Periphery/X3: D18.19 (IOA2), R85.2, X6.2
/Periphery/X4: D18.18 (IOA3), R84.2, X6.3
/Periphery/X5: D18.17 (IOA4), R83.2, X6.5
/Periphery/X6: D18.16 (IOA5), R82.2, X6.4
/Periphery/X7: D18.15 (IOA6), D82.19 (DB1)
/Periphery/X8: D18.14 (IOA7), D82.20 (DB0)
/Periphery/Y0: D17.14 (PC0), D19.15 (R/W), D78.10, D82.13 (AB0), D83.13 (AB0)
/Periphery/Y1: D17.15 (PC1), D19.14 (AS), D82.14 (AB1), D83.14 (AB1)
/Periphery/Y2: D17.16 (PC2), D19.17 (DS), D82.15 (AB2), D83.15 (AB2)
/Periphery/Y3: D17.17 (PC3), D78.9, D82.16 (AB3), D83.16 (AB3)
/Periphery/Z0: D82.5 (DAO), D84.2 (O0), D84.4 (D1)
/Periphery/Z1: D82.6 (DA1), D84.5 (O1), D84.7 (D2)
/Periphery/Z2: D82.7 (DA2), D84.6 (O2), D84.8 (D3)
/Periphery/Z3: D82.8 (DA3), D84.9 (O3), D84.13 (D4)
/Periphery/Z4: D83.5 (DAO), D84.12 (O4), D84.14 (D5)
/Periphery/Z5: D83.6 (DA1), D84.15 (O5), D84.17 (D6)
/Periphery/Z6: D83.7 (DA2), D84.16 (O6), D84.18 (D7)
/Periphery/Z7: D83.8 (DA3), D84.19 (O7)
/Periphery/~CS53: D33.21 (~CS), D42.6
/Periphery/~STROBE: D42.12, X5.A1.6
/RAM/CAS0: D1.15 (CAS), D2.15 (CAS), D3.15 (CAS), D4.15 (CAS), D5.15 (CAS), D6.15 (CAS), D7.15 (CAS), D8.15 (CAS), R79.2
/RAM/CAS1: D9.15 (CAS), D10.15 (CAS), D11.15 (CAS), D12.15 (CAS), D13.15 (CAS), D14.15 (CAS), D15.15 (CAS), D16.15 (CAS), R80.2
/RAM/MA0: D1.5 (A0), D2.5 (A0), D3.5 (A0), D4.5 (A0), D5.5 (A0), D6.5 (A0), D7.5 (A0), D8.5 (A0), D9.5 (A0), D10.5 (A0), D11.5 (A0), D12.5 (A0), D13.5 (A0), D14.5 (A0), D15.5 (A0), D16.5 (A0), R39.2
/RAM/MA1: D1.7 (A1), D2.7 (A1), D3.7 (A1), D4.7 (A1), D5.7 (A1), D6.7 (A1), D7.7 (A1), D8.7 (A1), D9.7 (A1), D10.7 (A1), D11.7 (A1), D12.7 (A1), D13.7 (A1), D14.7 (A1), D15.7 (A1), D16.7 (A1), R40.2
/RAM/MA2: D1.6 (A2), D2.6 (A2), D3.6 (A2), D4.6 (A2), D5.6 (A2), D6.6 (A2), D7.6 (A2), D8.6 (A2), D9.6 (A2), D10.6 (A2), D11.6 (A2), D12.6 (A2), D13.6 (A2), D14.6 (A2), D15.6 (A2), D16.6 (A2), R41.2
/RAM/MA3: D1.12 (A3), D2.12 (A3), D3.12 (A3), D4.12 (A3), D5.12 (A3), D6.12 (A3), D7.12 (A3), D8.12 (A3), D9.12 (A3), D10.12 (A3), D11.12 (A3), D12.12 (A3), D13.12 (A3), D14.12 (A3), D15.12 (A3), D16.12 (A3), R42.2
/RAM/MA4: D1.11 (A4), D2.11 (A4), D3.11 (A4), D4.11 (A4), D5.11 (A4), D6.11 (A4), D7.11 (A4), D8.11 (A4), D9.11 (A4), D10.11 (A4), D11.11 (A4), D12.11 (A4), D13.11 (A4), D14.11 (A4), D15.11 (A4), D16.11 (A4), R43.2
/RAM/MA5: D1.10 (A5_1), D2.10 (A5_1), D3.10 (A5_1), D4.10 (A5_1), D5.10 (A5_1), D6.10 (A5_1), D7.10 (A5_1), D8.10 (A5_1), D9.10 (A5_1), D10.10 (A5_1), D11.10 (A5_1), D12.10 (A5_1), D13.10 (A5_1), D14.10 (A5_1), D15.10 (A5_1), D16.10 (A5_1), R44.2
/RAM/MA6: D1.13 (A5_2), D2.13 (A5_2), D3.13 (A5_2), D4.13 (A5_2), D5.13 (A5_2), D6.13 (A5_2), D7.13 (A5_2), D8.13 (A5_2), D9.13 (A5_2), D10.13 (A5_2), D11.13 (A5_2), D12.13 (A5_2), D13.13 (A5_2), D14.13 (A5_2), D15.13 (A5_2), D16.13 (A5_2), R45.2
/RAM/MA7: D1.9 (A7), D2.9 (A7), D3.9 (A7), D4.9 (A7), D5.9 (A7), D6.9 (A7), D7.9 (A7), D8.9 (A7), D9.9 (A7), D10.9 (A7), D11.9 (A7), D12.9 (A7), D13.9 (A7), D14.9 (A7), D15.9 (A7), D16.9 (A7), R46.2
/RAM/MA8: D1.1 (A8), D2.1 (A8), D3.1 (A8), D4.1 (A8), D5.1 (A8), D6.1 (A8), D7.1 (A8), D8.1 (A8), D9.1 (A8), D10.1 (A8), D11.1 (A8), D12.1 (A8), D13.1 (A8), D14.1 (A8), D15.1 (A8), D16.1 (A8), R24.2
/RAM/R0: D1.14 (DOUT), D45.3 (D0), D47.3 (D0)
/RAM/R1: D2.14 (DOUT), D45.4 (D1), D47.4 (D1)
/RAM/R2: D3.14 (DOUT), D45.7 (D2), D47.7 (D2)
/RAM/R3: D4.14 (DOUT), D45.8 (D3), D47.8 (D3)
/RAM/R4: D5.14 (DOUT), D45.13 (D4), D47.13 (D4)
/RAM/R5: D6.14 (DOUT), D45.14 (D5), D47.14 (D5)
/RAM/R6: D7.14 (DOUT), D45.17 (D6), D47.17 (D6)
/RAM/R7: D8.14 (DOUT), D45.18 (D7), D47.18 (D7)
/RAM/R8: D9.14 (DOUT), D46.3 (D0), D48.3 (D0)
/RAM/R9: D10.14 (DOUT), D46.4 (D1), D48.4 (D1)
/RAM/R10: D11.14 (DOUT), D46.7 (D2), D48.7 (D2)
/RAM/R11: D12.14 (DOUT), D46.8 (D3), D48.8 (D3)
/RAM/R12: D13.14 (DOUT), D46.13 (D4), D48.13 (D4)
/RAM/R13: D14.14 (DOUT), D46.14 (D5), D48.14 (D5)
/RAM/R14: D15.14 (DOUT), D46.17 (D6), D48.17 (D6)
/RAM/R15: D16.14 (DOUT), D46.18 (D7), D48.18 (D7)
/RAM/RAS0: D1.4 (RAS), D2.4 (RAS), D3.4 (RAS), D4.4 (RAS), D5.4 (RAS), D6.4 (RAS), D7.4 (RAS), D8.4 (RAS), R77.2
/RAM/RAS1: D9.4 (RAS), D10.4 (RAS), D11.4 (RAS), D12.4 (RAS), D13.4 (RAS), D14.4 (RAS), D15.4 (RAS), D16.4 (RAS), R78.2
/RAM/S0: D20.14 (S0), D21.14 (S0), D22.14 (S0), D23.14 (S0), D24.11 (S0), D36.5, D42.10, D85.5
/RAM/VBUF: D43.1, D45.11 (LE), D46.11 (LE)
/RAM/WE0: D1.3 (WE), D2.3 (WE), D3.3 (WE), D4.3 (WE), D5.3 (WE), D6.3 (WE), D7.3 (WE), D8.3 (WE), R9.2
/RAM/WE1: D9.3 (WE), D10.3 (WE), D11.3 (WE), D12.3 (WE), D13.3 (WE), D14.3 (WE), D15.3 (WE), D16.3 (WE), R8.2
/RAM/~VCLK: D36.12, D43.6, D46.1 (OE)
/RAMDIS: D67.15 (A7), R14.2, X1.A23
/RAS: D39.6 (P3), D39.13 (Q2), D42.11, D77.11 (C), R77.1, R78.1
/RESET: C13.2, D17.35 (RESET), D34.21 (RESET), D42.2, D42.3, D70.1 (RESET), D70.16 (TC)
/ROM0: D35.10, D57.5 (Q)
/ROM1: D35.12, D57.9 (Q)
/ROMDIS: D31.22 (~OE), R25.1, X1.A22
/RSCLK: D34.20 (CLK), D72.11 (Q3)
/SINT: D66.3 (C), D79.12 (Q4), D85.13
/SINT*: D65.11 (Q2), D79.13 (D4)
/SOUND: R100.2, X1.A1, X2.6, X3.3, X3.5
/SYNC*: C4.2, D49.6 (P3), D65.9 (Q0)
/V1: D20.4 (I2a), D25.4 (MA0)
/V2: D20.12 (I2b), D25.5 (MA1)
/V3: D21.4 (I2a), D25.6 (MA2)
/V4: D21.12 (I2b), D25.7 (MA3)
/V5: D22.4 (I2a), D25.8 (MA4)
/V6: D23.4 (I2a), D25.9 (MA5)
/V7: D21.13 (I3b), D25.10 (MA6)
/V8: D20.3 (I3a), D25.11 (MA7)
/V9: D20.13 (I3b), D25.12 (MA8)
/V10: D21.3 (I3a), D25.13 (MA9)
/V14: D22.3 (I3a), D25.17 (MA13)
/V1113: D24.1 (I3), D24.12 (I7), D38.9 (Zd)
/VCLK: D36.13, D38.7 (Zb), D43.2, D44.2, D45.1 (OE), D85.4
/VD0: D45.2 (O0), D46.2 (O0), D50.3 (P0)
/VD1: D45.5 (O1), D46.5 (O1), D50.4 (P1)
/VD2: D45.6 (O2), D46.6 (O2), D50.5 (P2)
/VD3: D45.9 (O3), D46.9 (O3), D50.6 (P3)
/VD4: D45.12 (O4), D46.12 (O4), D51.3 (P0)
/VD5: D45.15 (O5), D46.15 (O5), D51.4 (P1)
/VD6: D45.16 (O6), D46.16 (O6), D51.5 (P2)
/VD7: D45.19 (O7), D46.19 (O7), D51.6 (P3)
/WGPTCLK: D33.9 (CLK0), D33.15 (CLK1), D70.19 (CLK), D72.8 (Q2)
/XD0: D32.3 (D0), D55.3 (D0), D56.3 (D0), D57.2 (D), D58.3 (D0), D60.5 (DAO), D62.9 (Q0), D71.12 (D), D87.15 (D1)
/XTAL: D37.2 (CP), D38.12 (Zc), D39.11 (Cp), D49.11 (Cp), D50.11 (Cp), D51.11 (Cp), D59.9 (Cp)
/~3CY: D77.4 (~S), D78.11, D82.11 (~WA), D83.11 (~WA)
/~BUSAK: D30.23 (~BUSACK), X1.B19
/~BUSRQ: D30.25 (~BUSRQ), RN2.4 (R3), X1.A19
/~CSAY: D32.15 (Q5), R36.1
/~DIS: D40.8 (~Q), D75.1, X1.B29
/~FUTURE: D41.8, D52.4 (I2a), D52.11 (I1b)
/~HALT: D30.18 (~HALT), X1.B17
/~INTA: D29.8, D66.10 (~S), X1.A29
/~INT: D30.16 (~INT), R15.2, X1.A18
/~IORD: D17.5 (~RD), D29.6, D34.13 (RD), D41.13, D70.2 (~RD), D82.21 (~RB), D82.22 (~ECB), D83.21 (~RB), D83.22 (~ECB), D89.19 (CE)
/~IORQ: D26.14 (A0), D29.2, D29.4, D29.10, D30.20 (~IORQ), D62.18 (~EP), D62.20 (~G), X1.A16
/~IOWR: D17.36 (~WR), D29.3, D29.12, D33.23 (~WR), D34.10 (WR), D41.12, D54.15 (Eb2), D70.3 (~WR), D74.15 (Eb2)
/~M1: D29.9, D30.27 (~M1), X1.A15
/~MREQ: D30.19 (~MREQ), D44.1, D67.2 (A5), X1.B14
/~NMI: D30.17 (~NMI), RN2.2 (R1), X1.B18
/~RAMEN: D67.9 (O3), RN5.5 (R4.2), X1.B22
/~RD: D29.5, D30.21 (~RD), D67.1 (A6), D75.2, X1.B16
/~RESET: D18.23 (~RESET), D19.18 (RESET), D32.1 (~Mr), D42.4, D55.1 (~Mr), D56.1 (~Mr), R135.1, X1.A21
/~RFSH: D30.28 (~RFSH), D40.4 (~S), D40.10 (~S), X1.B15
/~ROMEN: D31.20 (~CS), D67.10 (O2), RN5.4 (R3.2), X1.B21
/~WAIT: D30.24 (~WAIT), R7.2, X1.A20
/~WR: D29.1, D30.22 (~WR), X1.A17
GND: C4.1, C5.1, C6.2, C7.1, C8.2, C9.1, C10.2, C11.1, C12.1, C13.1, C14.2, C15.2, C16.2, C17.2, C18.1, C20.2, C22.2, C23.1, C24.2, C25.1, CB1.1, CB1#2.1, CB1#3.1, CB1#4.1, CB1#5.1, CB1#6.1, CB1#7.1, CB1#8.1, CB1#9.1, CB1#10.1, CB1#11.1, CB1#12.1, CB1#13.1, CB1#14.1, CB1#15.1, CB1#16.1, CB1#17.1, CB1#18.1, CB1#19.1, CB1#20.1, CB1#21.1, CB1#22.1, CB1#23.1, CB1#24.1, CB1#25.1, CB1#26.1, CB1#27.1, CB1#28.1, CB1#29.1, CB1#30.1, D1.16 (GND), D2.16 (GND), D3.16 (GND), D4.16 (GND), D5.16 (GND), D6.16 (GND), D7.16 (GND), D8.16 (GND), D9.16 (GND), D10.16 (GND), D11.16 (GND), D12.16 (GND), D13.16 (GND), D14.16 (GND), D15.16 (GND), D16.16 (GND), D17.7 (GND), D17.23 (PB5), D18.1 (Vss), D18.24 (~A9), D19.12 (VSS), D19.20 (CKFS), D20.1 (Ea), D20.8 (GND), D20.15 (Eb), D21.1 (Ea), D21.8 (GND), D21.15 (Eb), D22.1 (Ea), D22.8 (GND), D22.13 (I3b), D22.15 (Eb), D23.1 (Ea), D23.3 (I3a), D23.8 (GND), D23.13 (I3b), D23.15 (Eb), D24.7 (~E), D24.8 (GND), D25.1 (GND), D26.1 (OEa), D26.5 (I1a), D26.6 (I0a), D26.8 (GND), D26.10 (I0b), D26.11 (I1b), D26.15 (OEb), D28.8 (GND), D28.14 (CS2), D29.7 (GND), D30.29 (GND), D31.14 (GND), D32.8 (GND), D33.12 (GND), D34.4 (GND), D35.7 (GND), D36.7 (GND), D37.8 (GND), D38.8 (GND), D38.15 (OE), D39.8 (GND), D40.7 (GND), D41.7 (GND), D42.7 (GND), D43.7 (GND), D44.7 (GND), D45.10 (GND), D46.10 (GND), D47.10 (GND), D48.10 (GND), D49.8 (GND), D50.8 (GND), D51.8 (GND), D52.1 (Ea), D52.8 (GND), D52.12 (I2b), D52.15 (Eb), D53.1 (Ea), D53.4 (I2a), D53.5 (I1a), D53.8 (GND), D53.15 (Eb), D54.8 (GND), D55.8 (GND), D56.8 (GND), D57.7 (GND), D58.10 (GND), D59.8 (GND), D60.12 (GND), D61.12 (GND), D62.12 (VSS), D65.12 (VSS), D65.18 (~EP), D65.19 (A10), D65.20 (~G), D66.7 (GND), D66.12 (D), D67.8 (GND), D67.13 (W), D67.14 (~CE), D68.8 (GND), D69.8 (GND), D69.15 (Q), D70.20 (GND), D71.7 (GND), D72.2 (R0(1)), D72.3 (R0(2)), D72.10 (GND), D73.7 (GND), D74.2 (Ea2), D74.8 (GND), D75.7 (GND), D76.7 (GND), D77.2 (D), D77.7 (GND), D78.7 (GND), D79.8 (GND), D80.8 (GND), D81.7 (~E), D81.8 (GND), D82.12 (GND), D83.12 (GND), D84.1 (OE), D84.10 (GND), D85.7 (GND), D86.4 (GND), D87.8 (GND), D87.11 (~Er), D88.8 (GND), D89.10 (GND), IC63.1 (CA), IC63.8 (VSS), IC63.9 (CB), IC64.1 (CA), IC64.8 (VSS), P2.1, P6.1, P8.1, R5.1, R14.1, R25.2, R27.1, R51.1, R65.2, R66.2, R102.1, R105.1, R128.1, R130.1, R133.1, VD1.2 (A), VD11.2 (A), VD14.2 (A), VT1.1 (E), VT3.1 (E), VT4.1 (E), VT5.1 (E), X1.A25, X1.B1, X2.2, X2.7, X2.S (К), X3.2, X3.S (К), X4.B1, X4.B2, X4.B3, X4.B4, X4.B5, X4.B6, X4.B7, X4.B8, X4.B9, X4.B10, X4.B11, X4.B12, X4.B13, X4.B14 (B14~), X4.B15, X4.B16, X4.B17, X5.A1.2, X5.A1.S (К), X5.B1.S (К), X6.S (К), X7.2, X7.S (К), X8.1, X9.12
unnamed: C1.1, D36.2, R1.2
unnamed: C1.2, D36.3, R2.1
unnamed: C2.1, D36.10, R3.2
unnamed: C2.2, D36.9, R4.1
unnamed: C3.2, IC63.7 (RA), IC63.15 (RB), IC64.7 (RA), R5.2, VD1.1 (K)
unnamed: C9.2, D19.22 (PS), R34.1
unnamed: C11.2, D19.2 (OSC1), Q3.2, R37.1
unnamed: C12.2, Q3.1, R38.1
unnamed: C14.1, DR1.2, VT2.3 (C)
unnamed: C18.2, D68.13 (D4), D71.6 (~Q)
unnamed: C26.1, DR2.2, VD10.2 (A), VT4.3 (C)
unnamed: C26.2, VD13.1 (K), VD14.1 (K)
unnamed: D19.3 (OSC2), R37.2, R38.2
unnamed: D19.13 (CE), R35.1, VT1.3 (C)
unnamed: D20.7 (Za), R39.1
unnamed: D20.9 (Zb), R40.1
unnamed: D21.7 (Za), R41.1
unnamed: D21.9 (Zb), R42.1
unnamed: D22.7 (Za), R43.1
unnamed: D22.9 (Zb), R44.1
unnamed: D23.7 (Za), R45.1
unnamed: D23.9 (Zb), R46.1
unnamed: D24.5 (Z), R24.1
unnamed: D25.23 (E), D41.11
unnamed: D29.11, D57.3 (C), D57.11 (C)
unnamed: D31.1 (A15), D35.11
unnamed: D31.27 (A14), D35.8
unnamed: D32.9 (Cp), D44.6
unnamed: D35.5, D44.8
unnamed: D36.1, Q1.2, R1.1
unnamed: D36.6, D43.3, D43.5
unnamed: D36.11, Q2.2, R3.1
unnamed: D38.4 (Za), D39.5 (P2)
unnamed: D39.4 (P1), D39.15 (Q0)
unnamed: D40.2 (D), D75.3
unnamed: D40.6 (~Q), D41.1, D41.4
unnamed: D40.12 (D), D44.3
unnamed: D41.3, R8.1
unnamed: D41.5, D42.8
unnamed: D41.6, R9.1
unnamed: D43.8, D66.8 (~Q)
unnamed: D43.9, D85.11
unnamed: D43.13, VD2.1 (K)
unnamed: D49.3 (P0), D77.9 (Q)
unnamed: D49.4 (P1), D77.8 (~Q)
unnamed: D50.12 (Q3), D51.2 (Dsr), D52.3 (I3a), D52.5 (I1a), D52.6 (I0a)
unnamed: D50.14 (Q1), D53.3 (I3a), D53.6 (I0a)
unnamed: D51.14 (Q1), D52.10 (I0b), D52.13 (I3b)
unnamed: D54.10 (Q1b), R134.2
unnamed: D59.2 (Q0), R57.2
unnamed: D59.5 (Q1), R56.2
unnamed: D59.7 (Q2), R55.2
unnamed: D59.10 (Q3), R54.2
unnamed: D59.12 (Q4), R53.2
unnamed: D59.15 (Q5), R52.2
unnamed: D65.1 (A7), IC63.10 (EB), IC64.6 (Q3A)
unnamed: D65.6 (A2), IC63.5 (Q2A)
unnamed: D65.7 (A1), IC63.4 (Q1A)
unnamed: D65.8 (A0), IC63.3 (Q0A)
unnamed: D65.23 (A8), IC63.11 (Q0B)
unnamed: D66.2 (D), D66.6 (~Q)
unnamed: D66.5 (Q), D66.11 (C)
unnamed: D66.9 (Q), D66.13 (~R), R15.1
unnamed: D68.2 (Q0), D69.10 (A0)
unnamed: D68.5 (Q1), D69.11 (A1)
unnamed: D68.7 (Q2), D69.12 (A2)
unnamed: D68.9 (Cp), D72.9 (Q1)
unnamed: D68.10 (Q3), D69.13 (A3), D73.1
unnamed: D68.12 (Q4), D69.14 (A4), D71.1 (~R)
unnamed: D68.14 (D5), D71.5 (Q)
unnamed: D70.4 (~CS), D74.7 (Q0a)
unnamed: D70.15 (~DACK), R76.1
unnamed: D70.17 (IDX), D73.10
unnamed: D70.25 (WE), D76.1
unnamed: D70.27 (HD), D76.13
unnamed: D70.28 (US1), D73.3
unnamed: D70.29 (US0), D73.5, D75.10
unnamed: D70.30 (WDA), D76.11
unnamed: D70.33 (FLT_TR0), D85.3
unnamed: D70.34 (WP_TS), D73.8
unnamed: D70.37 (FR_STP), D75.4
unnamed: D70.38 (LCT_DIR), D76.9
unnamed: D71.11 (C), D74.9 (Q0b)
unnamed: D72.14 (CP0), D73.2
unnamed: D73.4, D75.9
unnamed: D73.6, D76.5
unnamed: D73.12, D85.1
unnamed: D75.11, VD9.1 (K)
unnamed: D77.5 (Q), IC64.15 (RB)
unnamed: D78.3, D78.4
unnamed: D78.6, D84.11 (Cp)
unnamed: D82.17 (DB3), R83.1
unnamed: D82.18 (DB2), R82.1
unnamed: D83.17 (DB3), R87.1
unnamed: D83.18 (DB2), R86.1
unnamed: D83.19 (DB1), R85.1
unnamed: D83.20 (DB0), R84.1
unnamed: D85.6, R7.1
unnamed: D86.1 (S), R123.1
unnamed: D88.6 (Q4), VD12.1 (K)
unnamed: P7.1, P7#2.1, R33.2, VD6.2 (A)
unnamed: R16.2, VD3.1 (K)
unnamed: R36.2, VT1.2 (B)
unnamed: R52.1, R53.1, R59.2, R62.2
unnamed: R54.1, R55.1, R60.2, R63.2
unnamed: R56.1, R57.1, R61.2, R64.2
unnamed: R58.1, R59.1, R60.1, R61.1, VD8.2 (A), VT2.2 (B)
unnamed: R65.1, VT2.1 (E)
unnamed: R81.2, X2.1
unnamed: R101.2, VD15.1 (K)
unnamed: R102.2, VD16.1 (K)
unnamed: R114.2, X5.A1.1
unnamed: R115.2, X5.A1.3
unnamed: R116.2, X5.A1.4
unnamed: R117.2, X5.A1.5
unnamed: R118.2, X5.A1.7
unnamed: R119.2, X5.B1.1
unnamed: R120.2, X5.B1.3
unnamed: R121.2, X5.B1.4
unnamed: R122.2, X5.B1.5
unnamed: R127.1, R128.2, VT3.2 (B)
unnamed: R127.2, X7.4, X7.7
unnamed: R129.2, R130.2, VT4.2 (B)
unnamed: R131.2, R133.2, VT5.2 (B)
VCC: C20.1, C22.1, CB1.2, CB1#2.2, CB1#3.2, CB1#4.2, CB1#5.2, CB1#6.2, CB1#7.2, CB1#8.2, CB1#9.2, CB1#10.2, CB1#11.2, CB1#12.2, CB1#13.2, CB1#14.2, CB1#15.2, CB1#16.2, CB1#17.2, CB1#18.2, CB1#19.2, CB1#20.2, CB1#21.2, CB1#22.2, CB1#23.2, CB1#24.2, CB1#25.2, CB1#26.2, CB1#27.2, CB1#28.2, CB1#29.2, CB1#30.2, D1.8 (VCC), D2.8 (VCC), D3.8 (VCC), D4.8 (VCC), D5.8 (VCC), D6.8 (VCC), D7.8 (VCC), D8.8 (VCC), D9.8 (VCC), D10.8 (VCC), D11.8 (VCC), D12.8 (VCC), D13.8 (VCC), D14.8 (VCC), D15.8 (VCC), D16.8 (VCC), D17.26 (VCC), D18.25 (A8), D18.28 (BC2), D18.40 (Vcc), D20.16 (VCC), D21.16 (VCC), D22.16 (VCC), D23.16 (VCC), D24.16 (VCC), D25.20 (VCC), D26.16 (VCC), D28.16 (VCC), D29.14 (VCC), D30.11 (VCC), D31.28 (VCC), D32.16 (VCC), D33.11 (G0), D33.14 (G1), D33.22 (~RD), D33.24 (VCC), D34.26 (VCC), D35.14 (VCC), D36.14 (VCC), D37.1 (~MR), D37.7 (CEP), D37.9 (~PE), D37.10 (CET), D37.16 (VCC), D38.16 (VCC), D39.1 (Mr), D39.9 (S0), D39.10 (S1), D39.16 (VCC), D40.1 (~R), D40.13 (~R), D40.14 (VCC), D41.14 (VCC), D42.14 (VCC), D43.14 (VCC), D44.14 (VCC), D45.20 (VCC), D46.20 (VCC), D47.20 (VCC), D48.20 (VCC), D49.1 (Mr), D49.16 (VCC), D50.1 (Mr), D50.16 (VCC), D51.1 (Mr), D51.16 (VCC), D52.16 (VCC), D53.12 (I2b), D53.16 (VCC), D54.16 (VCC), D55.16 (VCC), D56.16 (VCC), D57.1 (~R), D57.4 (~S), D57.10 (~S), D57.13 (~R), D57.14 (VCC), D58.20 (VCC), D59.16 (VCC), D60.9 (~RA), D60.23 (~WB), D60.24 (VCC), D61.9 (~RA), D61.23 (~WB), D61.24 (VCC), D62.21 (VPP), D62.24 (VCC), D65.21 (VPP), D65.24 (VCC), D66.1 (~R), D66.14 (VCC), D67.16 (VCC), D68.1 (~Mr), D68.16 (VCC), D69.16 (VCC), D70.40 (Vcc), D71.4 (~S), D71.10 (~S), D71.13 (~R), D71.14 (VCC), D72.5 (VCC), D73.14 (VCC), D74.16 (VCC), D75.14 (VCC), D76.14 (VCC), D77.1 (~R), D77.10 (~S), D77.13 (~R), D77.14 (VCC), D78.1, D78.13, D78.14 (VCC), D79.1 (~Mr), D79.16 (VCC), D80.16 (VCC), D81.16 (VCC), D82.9 (~RA), D82.23 (~WB), D82.24 (VCC), D83.9 (~RA), D83.23 (~WB), D83.24 (VCC), D84.20 (VCC), D85.14 (VCC), D87.16 (VCC), D88.16 (VCC), D89.20 (VCC), DR1.1, DR2.1, IC63.16 (VDD), IC64.16 (VDD), P1.1, P5.1, R26.2, R58.2, R76.2, R123.2, R126.2, R132.1, RN1.1 (common), RN2.1 (common), RN3.1 (common), RN4.1 (R1.1), RN5.1 (R1.1), RN6.1 (R1.1), RN7.1 (R1.1), RN8.1 (R1.1), RN9.1 (common), VD3.2 (A), VD4.1, VD5.1 (K), VD7.2 (A), VD15.2 (A), VD16.2 (A), X1.A14, X5.B1.6, X5.B1.7
