lucedoriente/Aleste520ex/(commit log)

2026-10-17 Release 2026: Complete KiCad 9 Western THT schematic & routed PCB (AM29705 fix, U1-U89, 0 ERC/DRC)
2026-10-17 Include original ROM/PROM binary images (rom/*.BIN) and socket mapping table in README
2026-10-17 Update README.md and README.it.md with exact Edge.Cuts PCB dimensions (400.9 x 280.5 mm)
2026-10-17 Reorganize into board/, keyboard/, case/, rom/; upgrade X8/X9 to 2x06 2.54mm; add 11 M3 holes & PicoPSU wiring; add Cherry MX NKRO keyboard & anti-flex OpenSCAD case
2026-10-17 Convert 3D case CAD files to native FreeCAD 1.1 (.FCStd, .step, .FCMacro)
2026-10-17 Center silkscreen text between MH2 and MH3 on keyboard PCB; add full component footprints and 3D models (.wrl/.step) to SW1..SW82, D1..D81, J1, J2, X8, X9
2026-10-17 Feat(keyboard,case): decode RFVDKEY.BIN/AL512.BIN matrix, redesign staggered keyboard PCB with 6.25U stabilized Spacebar, and convert case to FreeCAD 1.1 (.FCStd)
2026-10-17 Chore(case): remove temporary FreeCAD .FCBak backup files
2026-10-17 Feat(case): add captive-nut M3 joiners, Allen access troughs, staggered rod tunnels, and interlocking pins to Bottom and Top quadrants
2026-10-17 Feat(case): include Plate_Left_Half and Plate_Right_Half in 256x256mm printable group
2026-10-17 Feat(jlcpcb): export standalone STEP/STL files for JLC3DP and Gerber+Drill ZIP archives for JLCPCB
2026-10-17 Feat(keyboard): add JLCPCB Gerber ZIP for FR4/Aluminum Switch Plate
2026-10-17 Fix(case): eliminate thin walls (<2.5mm) on Whole and Quadrant STL/STEP models for JLCPCB DFM
2026-10-17 Feat(gerber): generate JLCPCB-compliant RS-274X Gerber + PTH/NPTH Excellon Drill ZIPs in jlcpcb_gerbers/
2026-10-17 Fix(gerber): include full RS-274X Protel Gerber layers + PTH/NPTH Excellon drills in JLCPCB ZIPs
